DudeYarvie/JARViE_Home_Automation_Modem/Firmware/src/Shahara/Programming the PLM Shahara CCA using Atmel Studio.pdf

# Programming the PLM Shahara

Author: Jarvis Hill
Date: 26-MAR-2023
Purpose: Use this document to perform ISP programming on the PLM Shahara
1. Navigate to the following website, https://www.microchip.com/en-us/development-tools-tools-and-software/avr-and-samdownloads-archive (https://www.microchip.com/en-us/development-tools-tools-and-software/avr-and-sam-downloads-archive)
2. Download and install Atmel Studio 7 on your PC by clicking the link circled below,

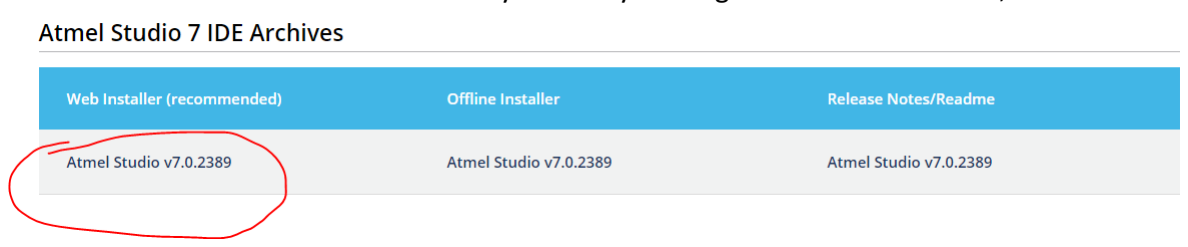
[picture p15: figure]

3. Connect the programmer to the PC using the appropriate USB cable.
4. Open/launch the Atmel Studio software on the PC,
5. Once the application opens, navigate to Tools -> Device Programming

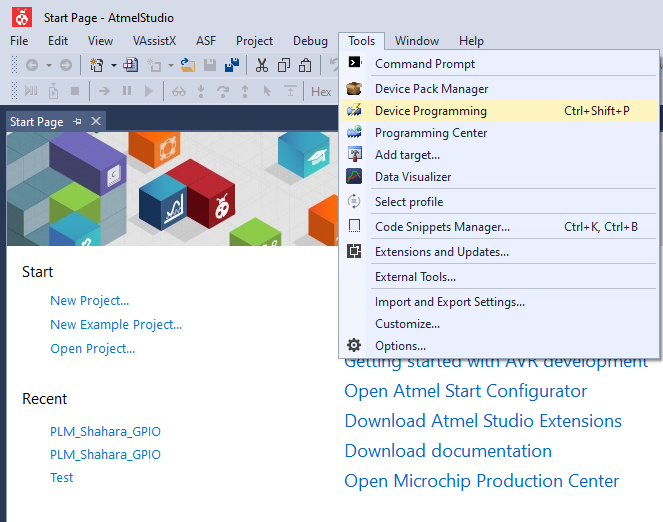
[picture p16: figure]
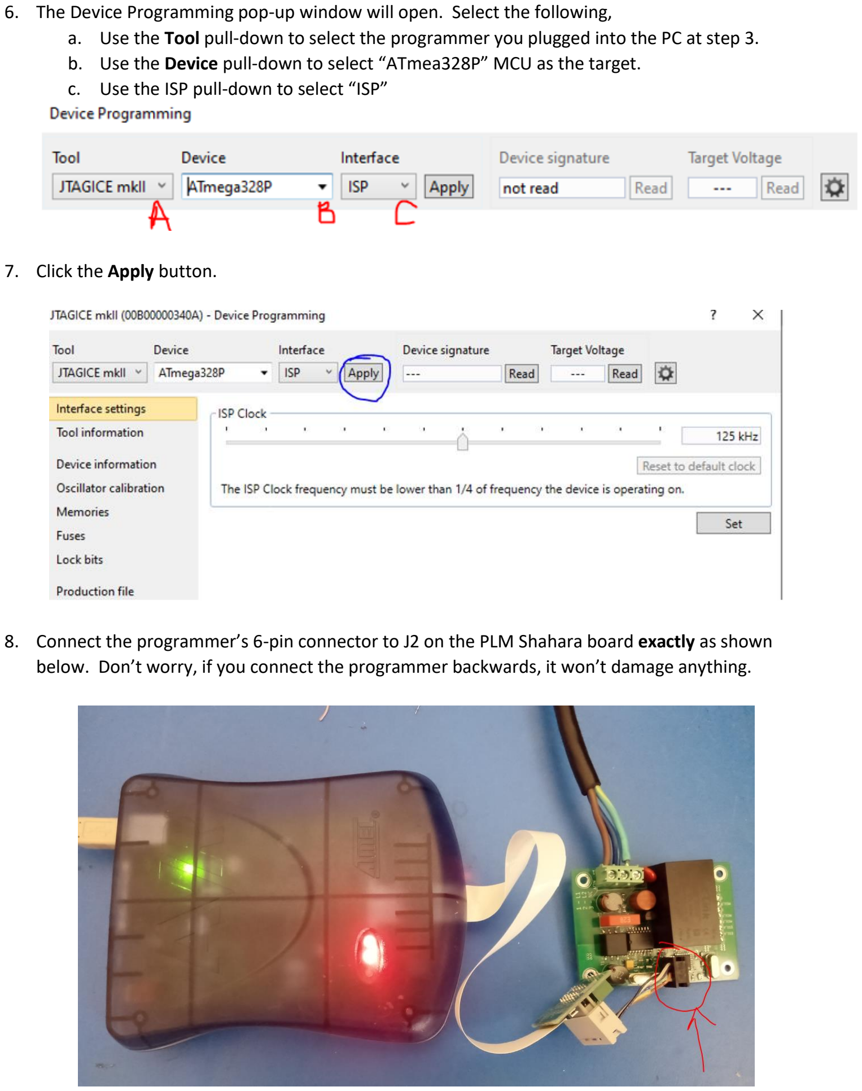
[picture p17: page 2]

6. The Device Programming pop-up window will open. Select the following,
a. Use the Tool pull-down to select the programmer you plugged into the PC at step 3.
b. Use the Device pull-down to select “ATmea328P” MCU as the target.
c. Use the ISP pull-down to select “ISP”
7. Click the Apply button.
8. Connect the programmer’s 6-pin connector to J2 on the PLM Shahara board exactly as shown below. Don’t worry, if you connect the programmer backwards, it won’t damage anything.

9. Power the PLM Shahara board by supplying 120 or 240VAC to the ACIN L1 and L2 screw terminals. The green light on the programmer should turn-on. If the LED does not come on, remove, rotate the programmer’s header by 180 degrees and plug it back into the 6-pin header on the Shahara board.

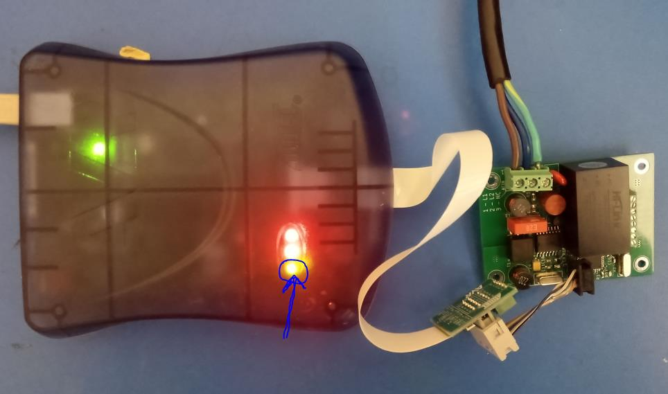
[picture p18: figure]

10. Click the Read button in the Device Signature Field. Verify the following,
a. A 4-digit HEX number populates in the Device Signature field
b. The Target Voltage is between 4.5V to 5V.
c. Device ID is read OK.

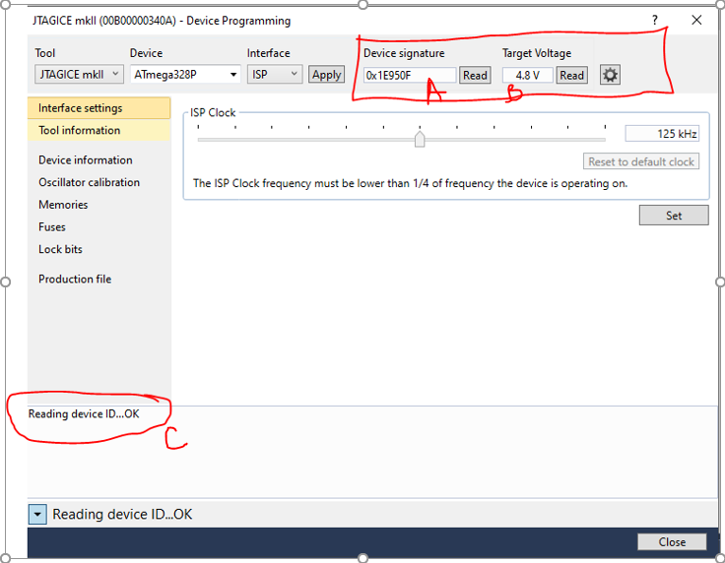
[picture p19: figure]

11. Navigate to the Fuses page. Ensure the CCA fuses are set correctly,
a. Click the Read button.
b. Verify that the EXTENDED, HIGH and LOW fuse registers read as shown. If not, update the registers with the values below.
c. Ensure the boxes are checked as shown.
d. IF the fuses registers were update, click the Program button

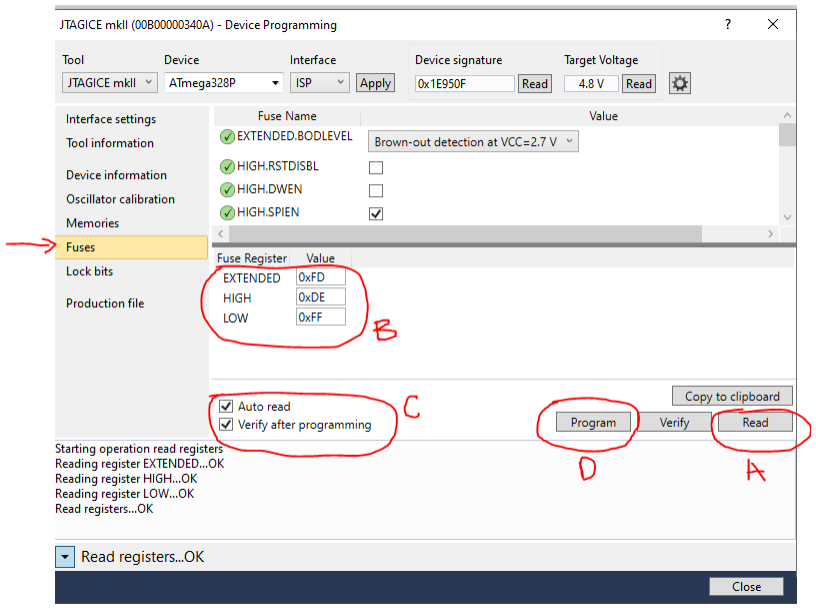
[picture p20: figure]

12. Navigate to the Memories page. Verify that the following boxes are checked.

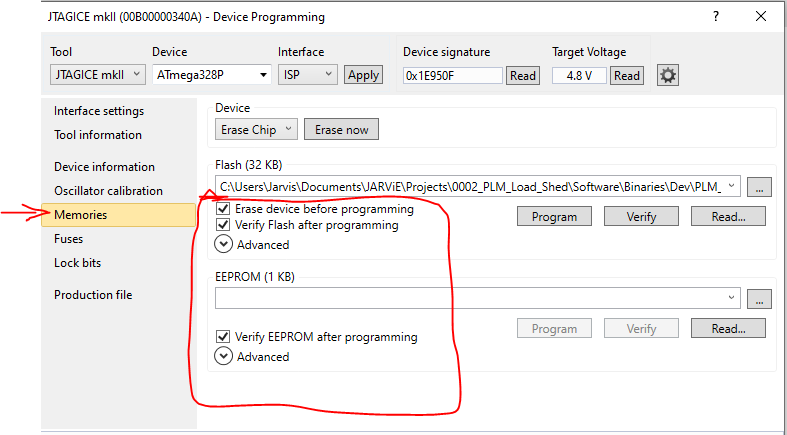
[picture p21: figure]

13. Load the program to be placed on the PLM Shahara CCA,
a. Click the button with the “…” in the Flash (32 kB) section
b. Select the .hex file to program onto the CCA
c. Double click the file to select it or click the file once to highlight it and then click the Open button in the file explorer window.

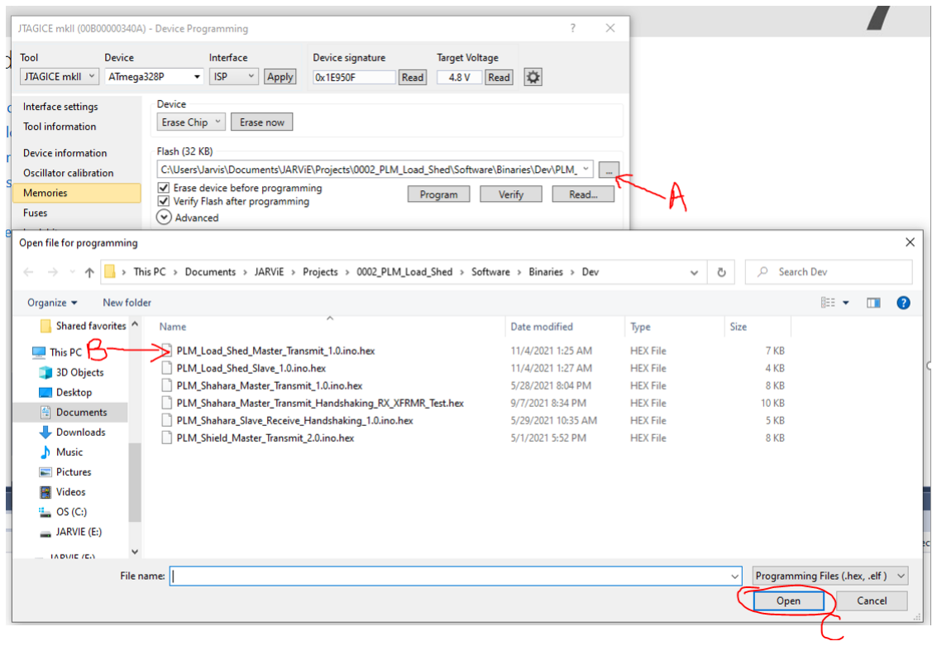
[picture p22: figure]

14. Upload the program to the PLM Shahara,
a. Click the Program button to load the CCA with the selected firmware (.hex file)
b. Verify that the programming went OK.

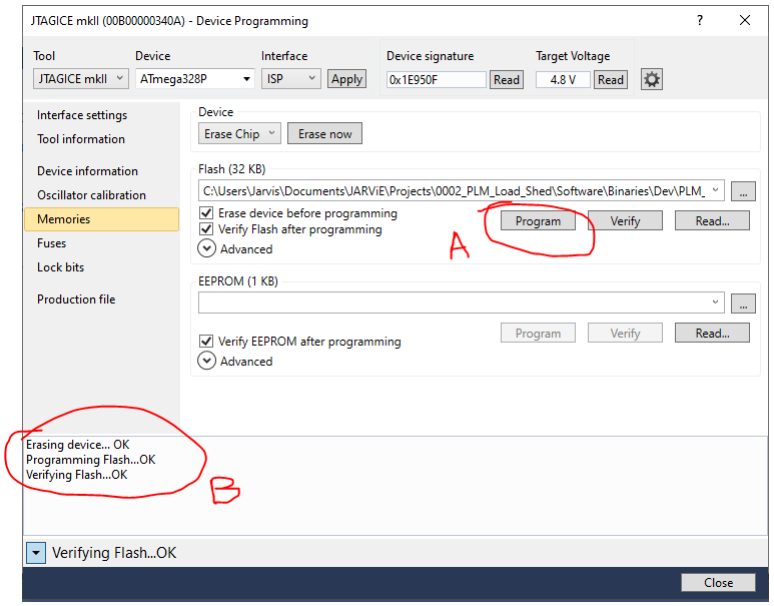
[picture p23: figure]
