DudeYarvie/JARViE_Home_Automation_Modem/Reference Docs/Pics/Demo_Kit.jpg

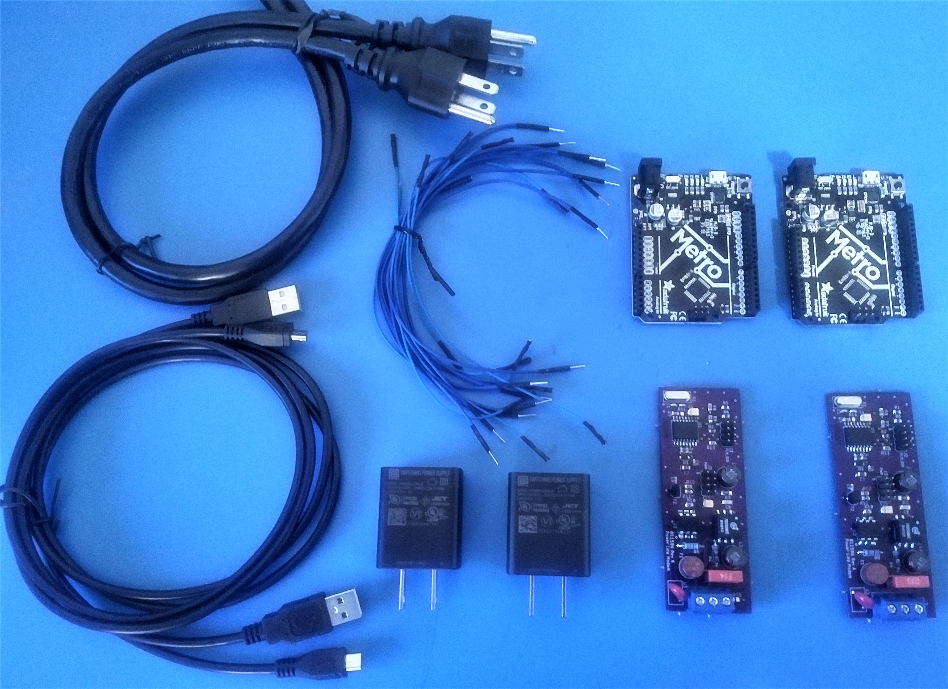
Reference Docs/Pics/Demo_Kit.jpg
