DudeYarvie/JARViE_Home_Automation_Modem/Reference Docs/Pics/JARVIE_PLM_Annotated.png

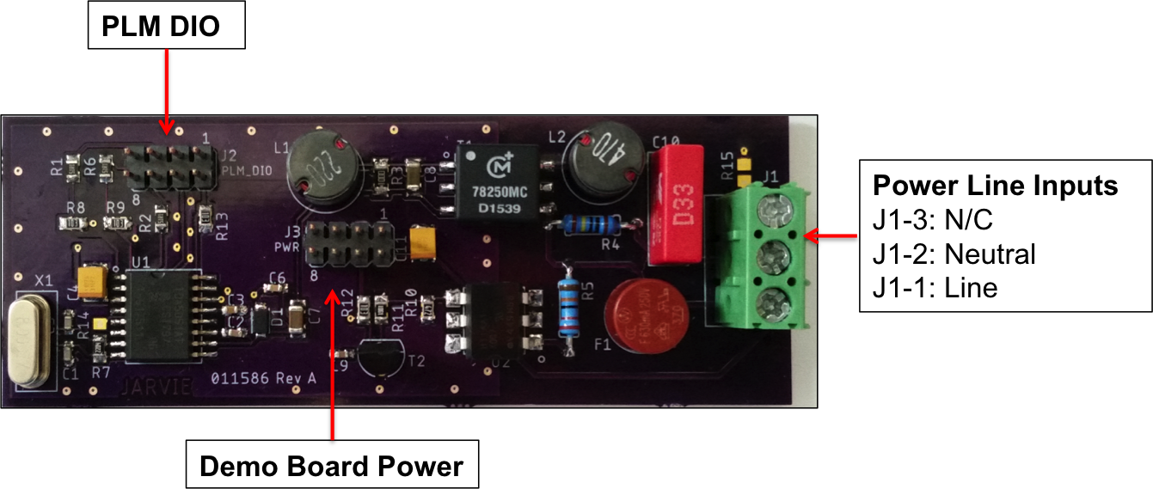
Reference Docs/Pics/JARVIE_PLM_Annotated.png
