DudeYarvie/JARViE_Home_Automation_Modem/Reference Docs/Pics/JARViE_PLM_HAT_AC_Application.png

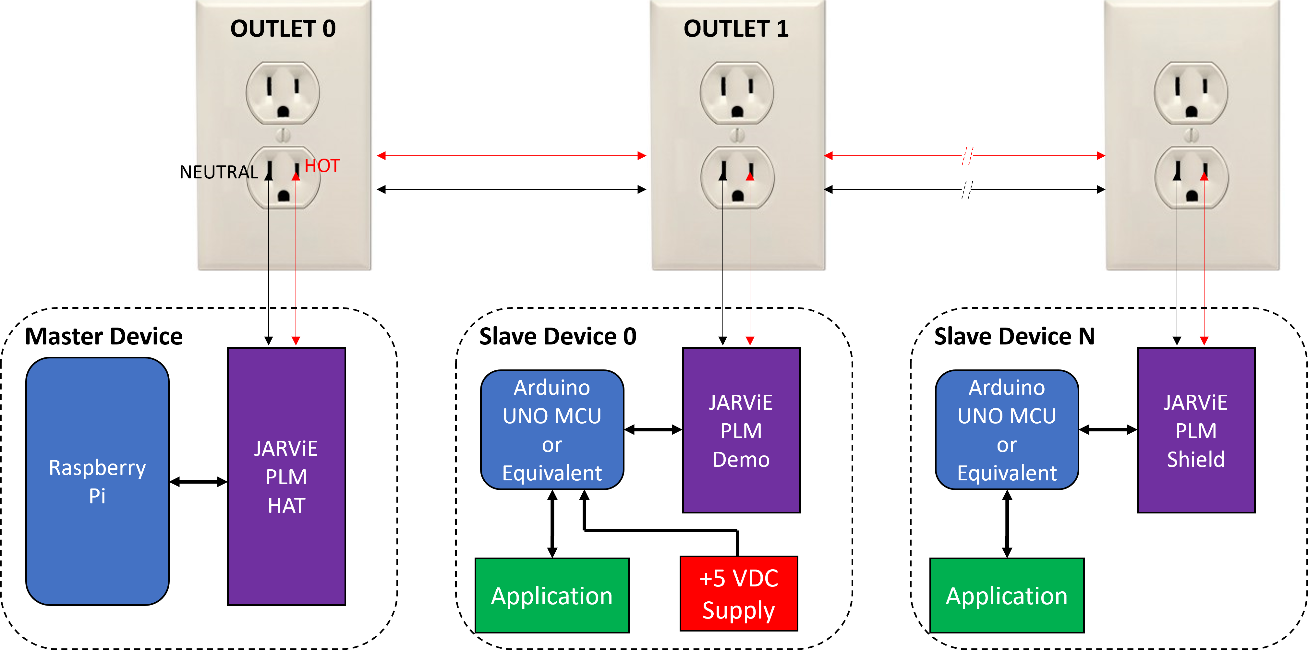
Reference Docs/Pics/JARViE_PLM_HAT_AC_Application.png
