DudeYarvie/JARViE_Home_Automation_Modem/Reference Docs/Pics/PLC_Coupling_Circuit_from_ACIN_to_PLC_Modem_Voltage_Magnitude_vs_Frequency.png

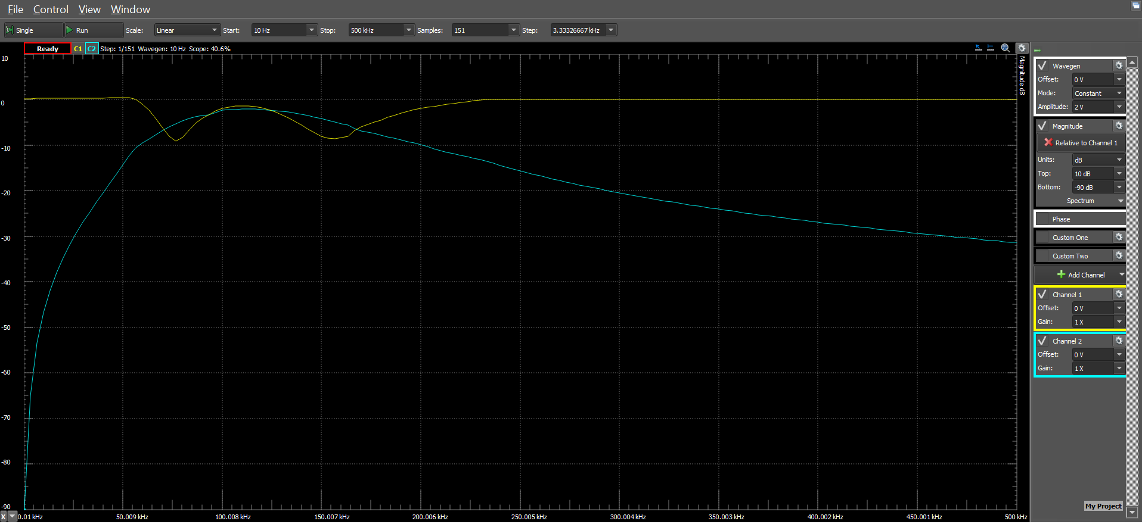
Reference Docs/Pics/PLC_Coupling_Circuit_from_ACIN_to_PLC_Modem_Voltage_Magnitude_vs_Frequency.png
