DudeYarvie/JARViE_Home_Automation_Modem/Reference Docs/Pics/PLC_Coupling_Circuit_from_PLC_Modem_to_ACIN_Voltage_Response_vs_Frequency.png

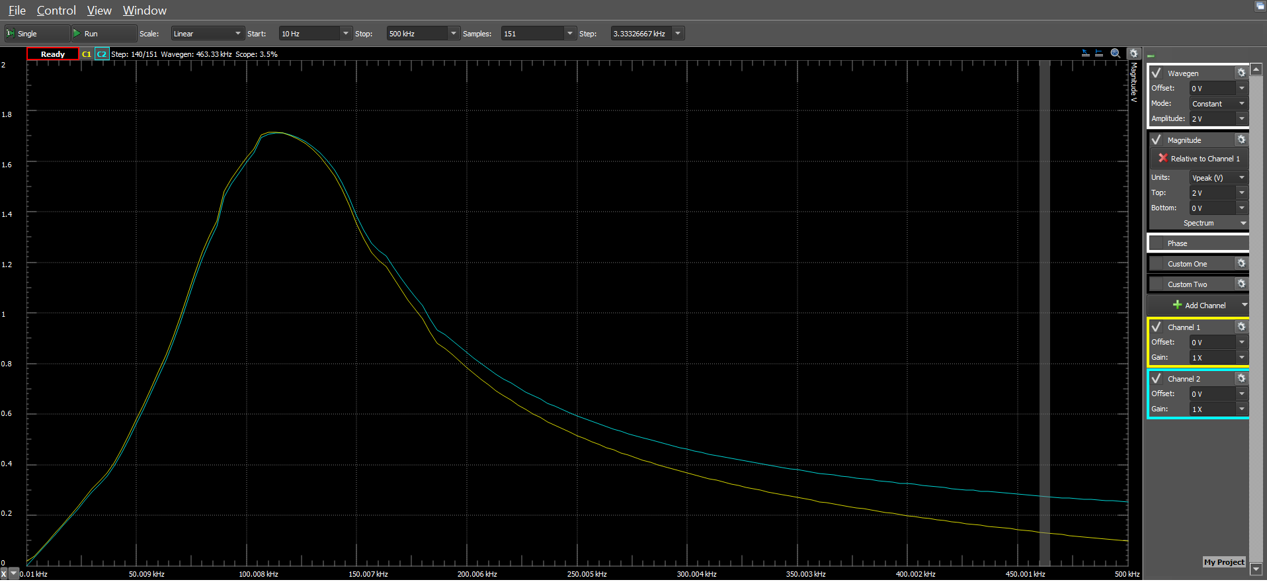
Reference Docs/Pics/PLC_Coupling_Circuit_from_PLC_Modem_to_ACIN_Voltage_Response_vs_Frequency.png
