DudeYarvie/JARViE_Home_Automation_Modem/Reference Docs/Pics/PLM_Shahara_Board_Rendering.PNG

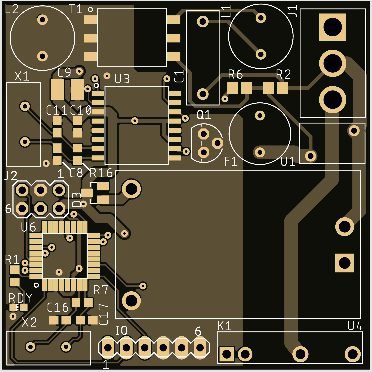
Reference Docs/Pics/PLM_Shahara_Board_Rendering.PNG
