DudeYarvie/JARViE_Home_Automation_Modem/Reference Docs/Pics/Shield_Demo_Kit.jpg

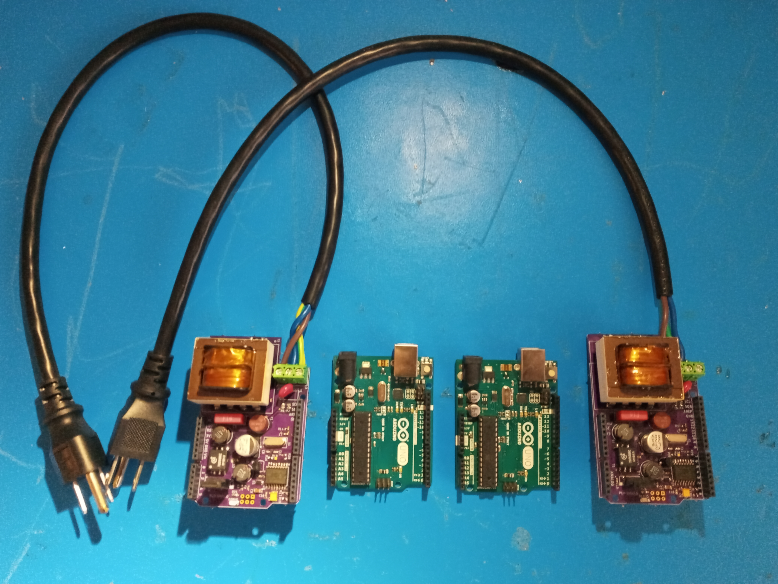
Reference Docs/Pics/Shield_Demo_Kit.jpg
