DudeYarvie/JARViE_Home_Automation_Modem/Reference Docs/RPI_HAT_Bringup.docx

+5V Raw Back Powering

1. Supply external +5V @ 30mA min current limited supply to +5V and GND inputs on RPI header
2. Measure voltage across C6, C12 or C13 and ensure voltage measurement is less than 0.5V

Results: Voltage read 0V across C13 when a +5V supply was connected to RPI header. Body diode of Q1 is correctly preventing a back-powering event

PLM EXT CLK INPUT

1. Measure CLK signal supplied at CLK_OUT pin of PLM IC using an oscilloscope.
2. Verify measured CLK_OUT frequency equals fosc/2 = 4MHz.

Results:

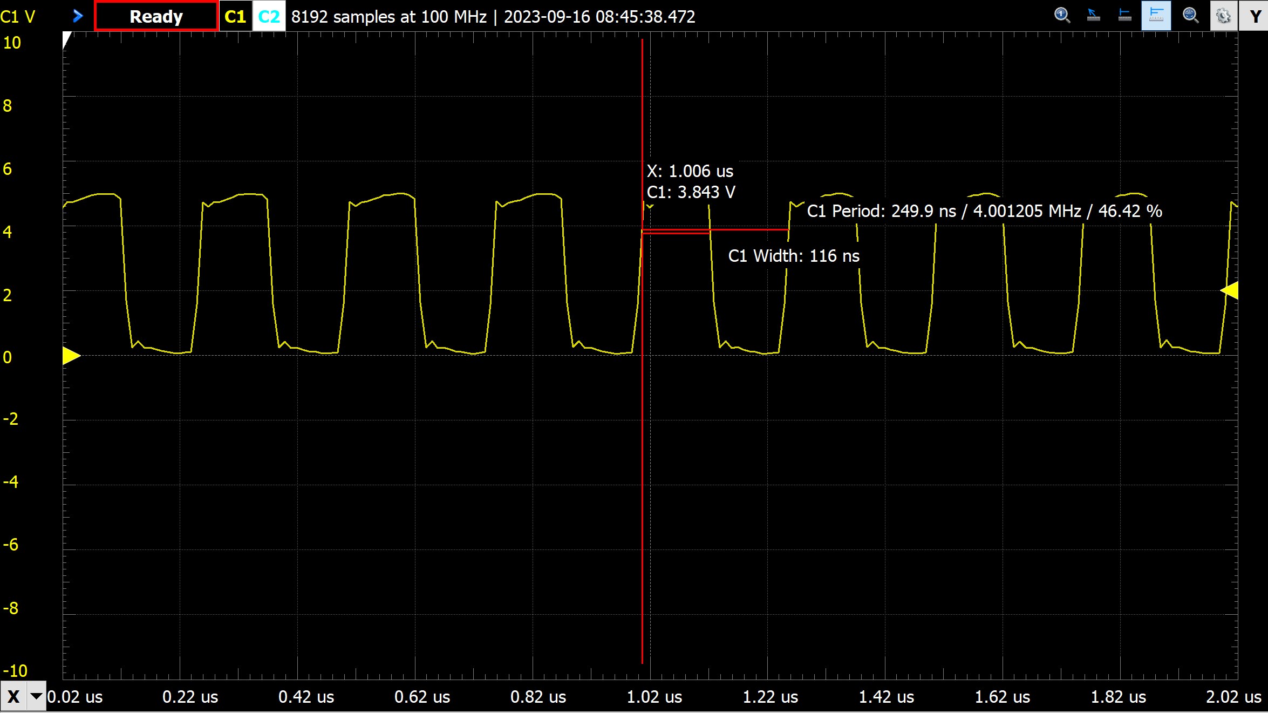
[picture p37: figure]

PLM TX OUTPUT

1. Supply a square waveform generator to PLM TX pin
2. Measure signal at ACIN output

Results

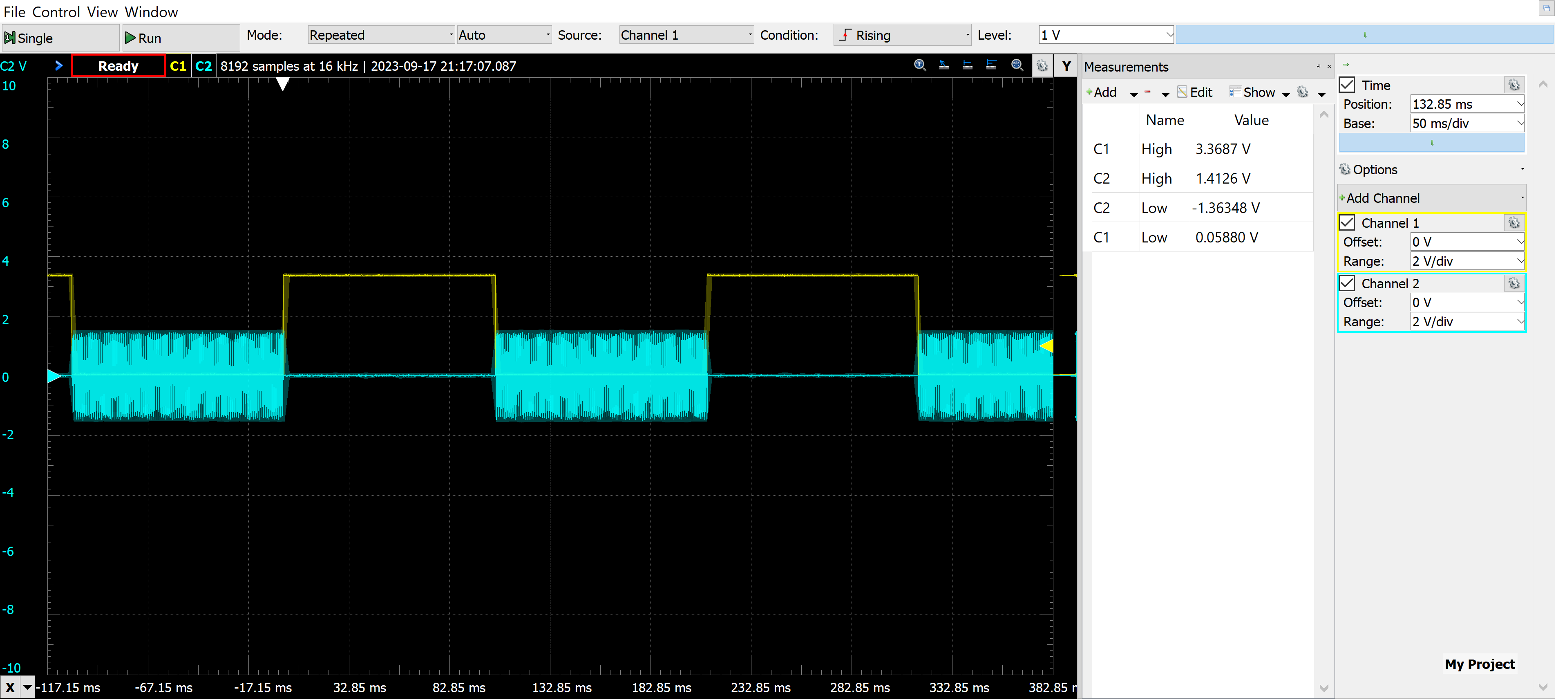
[picture p38: figure]

JARViE was sent on RPI ttyS0 serial bus:

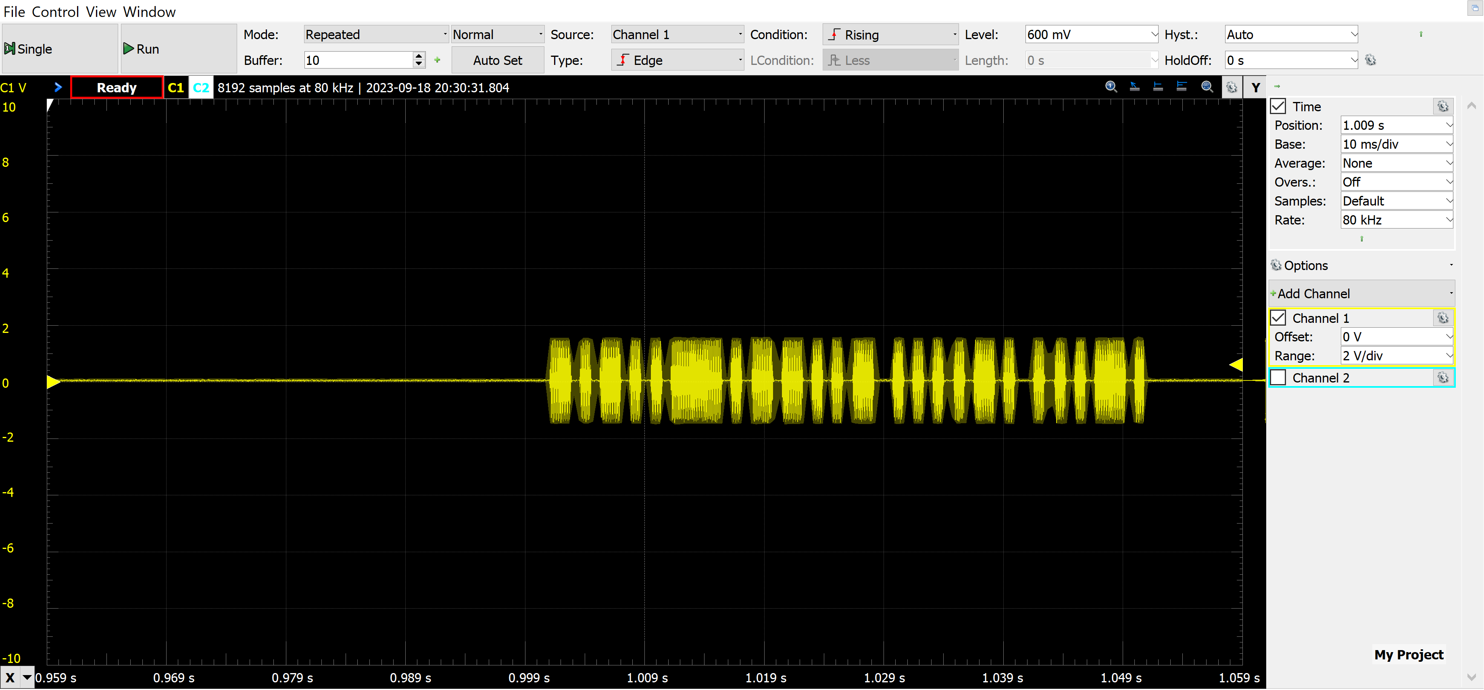
[picture p39: figure]

Communications Carrier frequency:

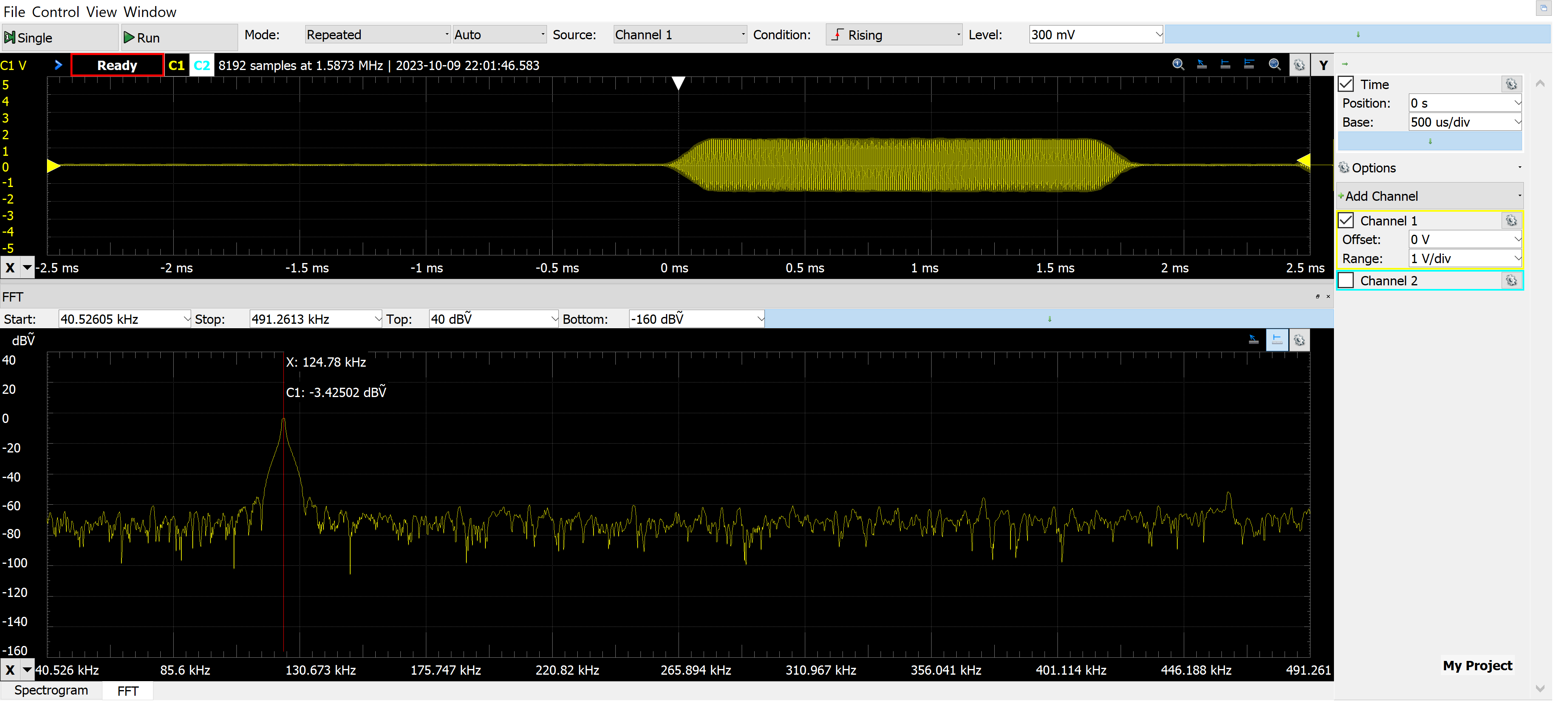
[picture p40: figure]

RPI BOOT w/ AC power adapter

1. Power down raspberry PI
2. Plug RPI Shield into raspberry PI
3. Power on raspberry PI using a USB-C power adapter (5V @ ?A)
4. Verify PI boots normally
5. Measure +3V and +5V power rails on the shield

Results

PI boots up properly

+3V and +5V power rails look good

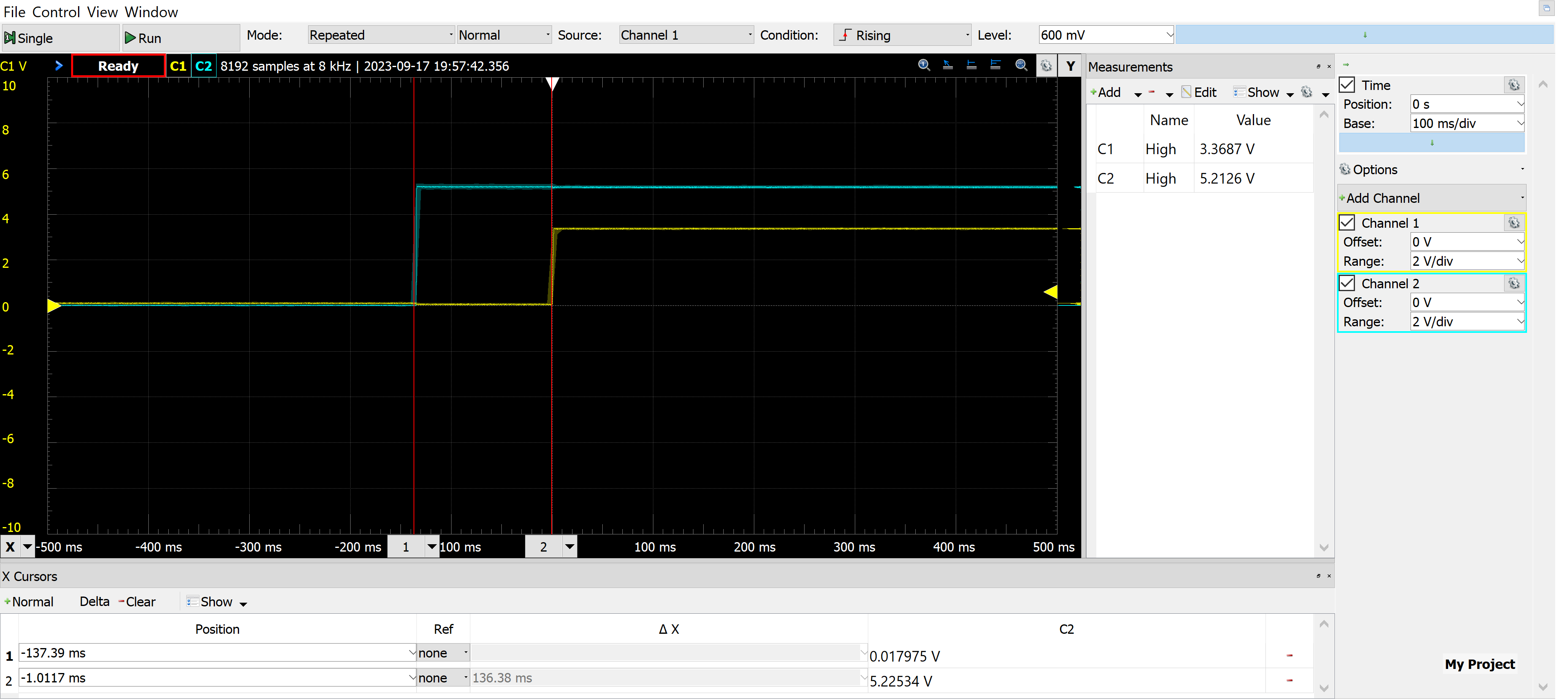
[picture p41: figure]

RPI BOOT w/ Shield 115VAC power

1. Power down raspberry PI
2. Plug RPI Shield into raspberry PI
3. Connect AC power to RPI Shield via ACIN connector
4. Plug AC power plug into 115VAC wall outlet
5. Verify PI boots normally
6. Measure ACIN, +3V and +5V power rails on the shield w/ DMM

Results

RPI booted up properly

ACIN = 124.0 VAC

+5V = 4.94 VDC

+3V = 3.29 VDC

3V to 5V Level Translation

1. Generate square wave on PLM DIN RPI TX pin
2. Connect scope to PLM DIN RPI TX pin and set scope to trigger on rising edge of this signal
3. Connect scope to PLM DIN pin

Results

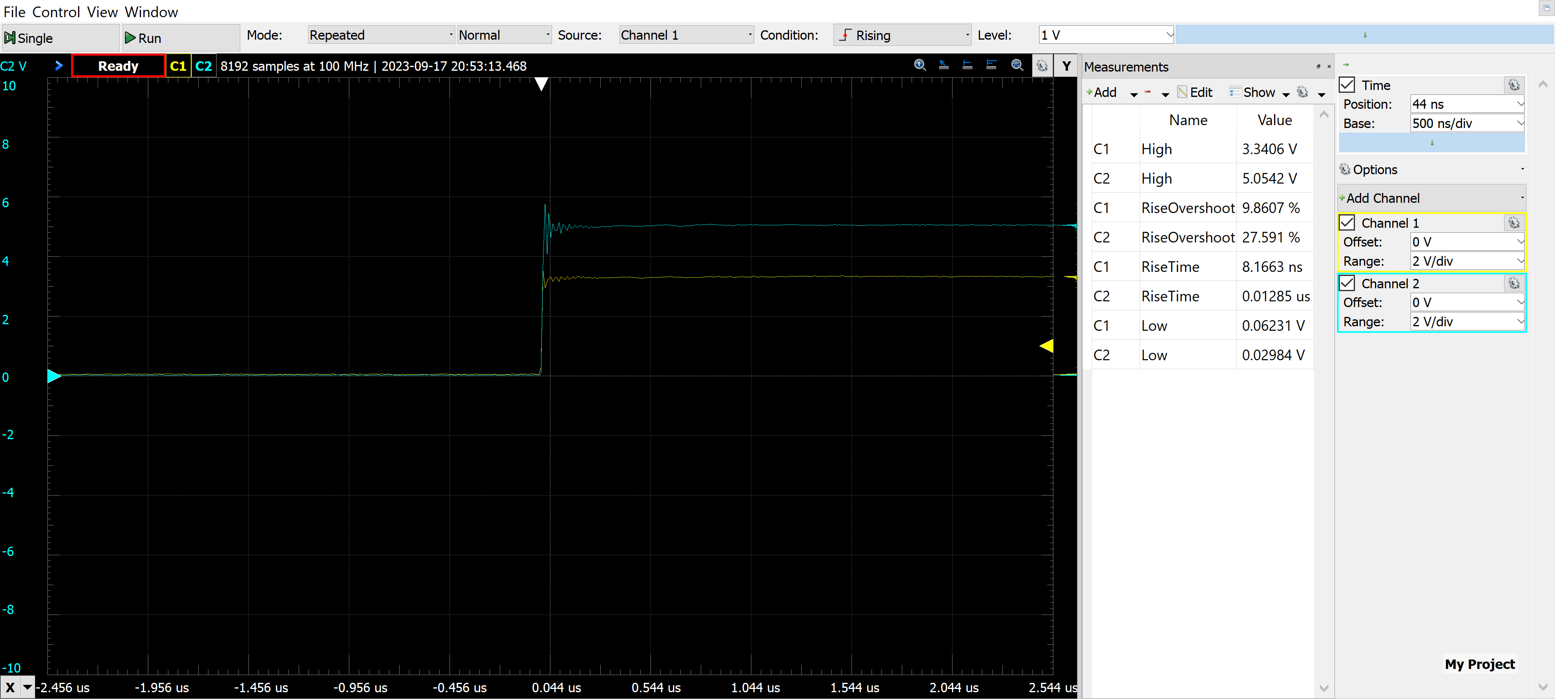
[picture p42: figure]
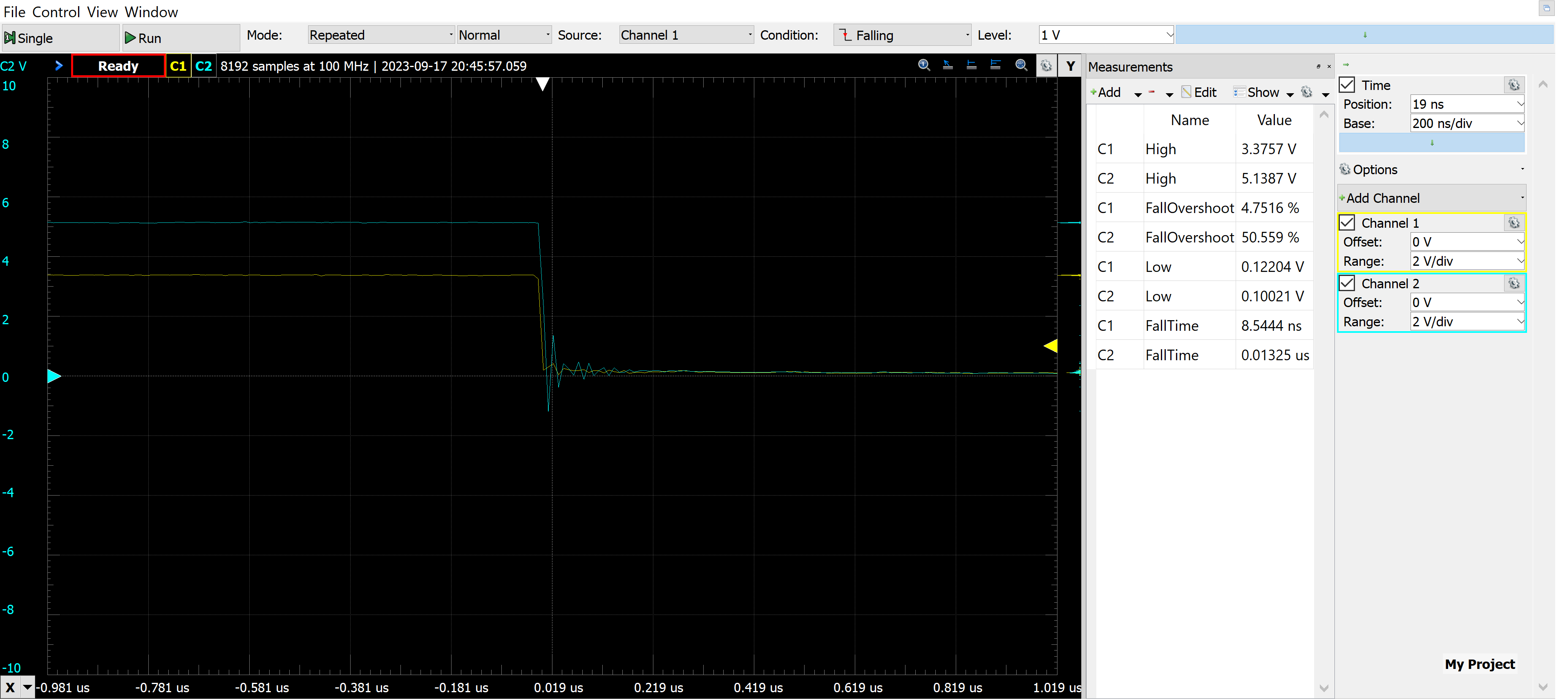
[picture p43: figure]

RPI HAT Powerline Communications

1. Enable RPI to run powerline comm script at boot.
2. Plug RPI HAT into raspberry PI
3. Plug RPI HAT in AC home outlet
4. Plug JARViE powerline demo board into a home outlet
5. …..add more steps

Results

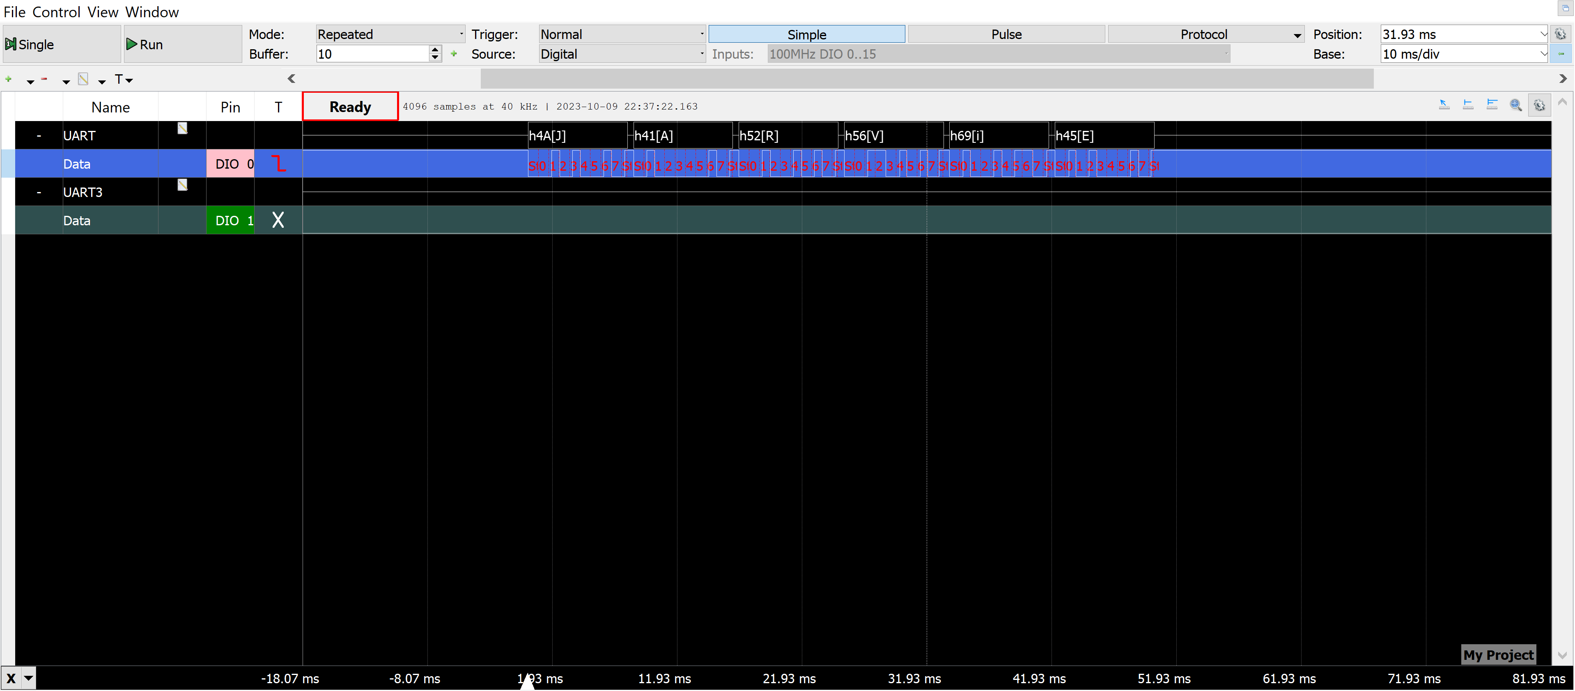
[picture p44: figure]

Setup the WLAN

1. Connect keyboard and mouse to RPI USB A ports.
2. Connect RPI to a display via micro HDMI port.
3. Follow instructions here to setup WLAN: https://raspberrytips.com/raspberry-pi-wifi-setup/
4. Once the WLAN is setup, connect to a network.
5. Verify that the RPI does not lose power or reboot.
6. Unpower RPI and apply power via RPI HAT, ensure RPI successfully boots and don’t not get stuck in a boot loop.

Setup Remote Desktop Access (RDP) on RPI

1. Open terminal on RPI and type sudo apt-get update to ensure you have the latest apt-get packages. If error is report stating an error or packages were ignored, re-run cmd until all packages install.
2. Follow instructions here to setup RDP on the RPI: https://elluminetpress.com/2020/03/connect-to-your-raspberry-pi-remotely/

SSH into RPI

1. Enable and login via SSH by following these instructions: https://phoenixnap.com/kb/enable-ssh-raspberry-pi
2. Type hostname -I into terminal on RPI, it will print the IP address, this is the IP address to use for the SSH connection in order to SSH into the RPI.

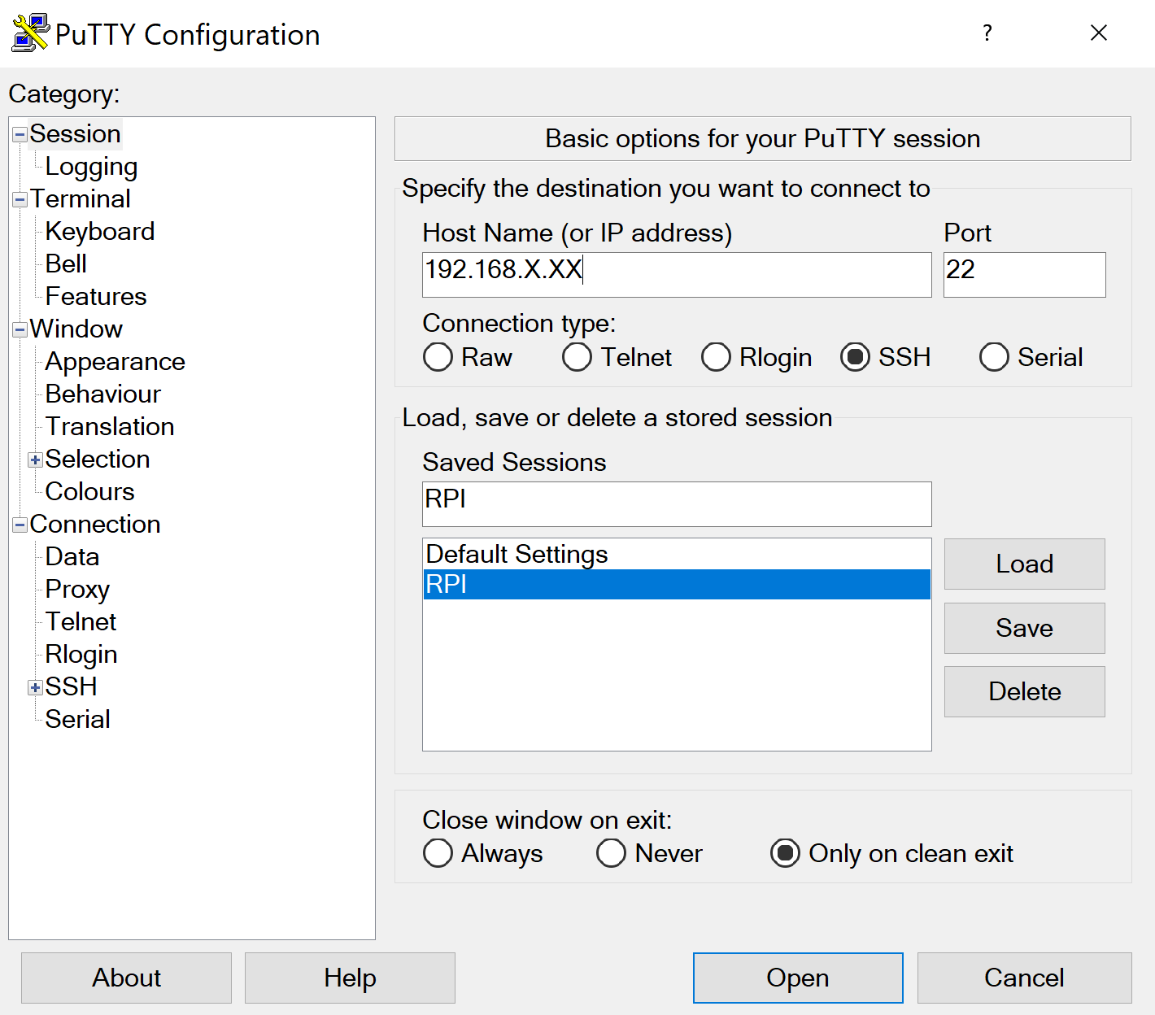
[picture p45: figure]
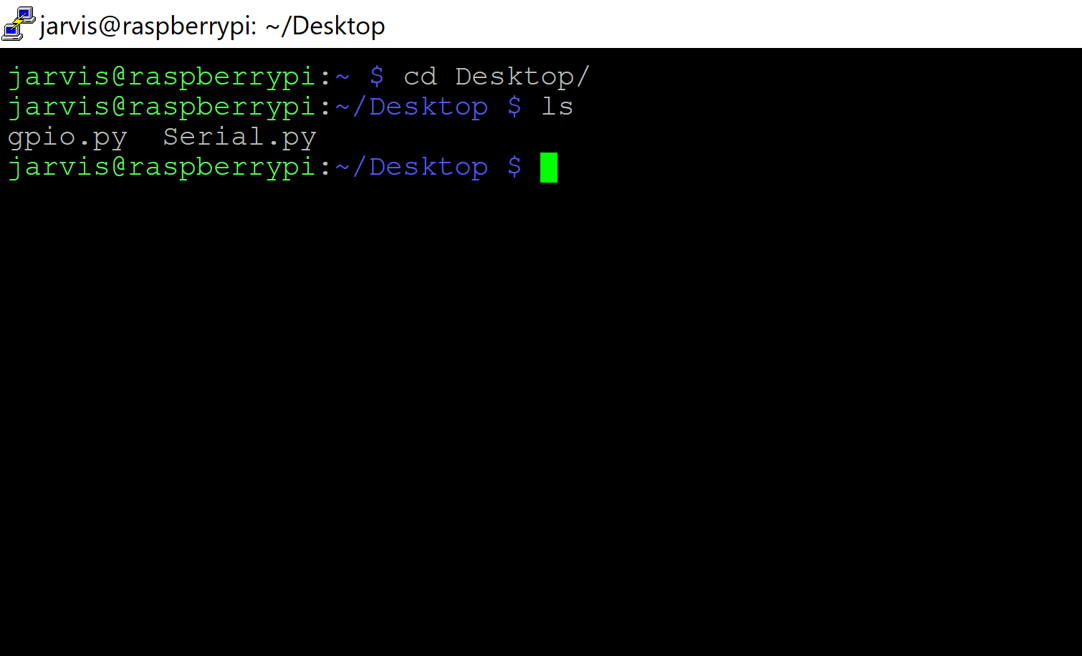
[picture p46: figure]

Run Python script at boot (init.d approach is what I used)

1. https://www.dexterindustries.com/howto/run-a-program-on-your-raspberry-pi-at-startup/
