DudeYarvie/JARViE_Home_Automation_Modem/(threads)

Thread 1 (2020-10-13):

plc dont work for more then 2 meters, and without AC volt

shalom198, 2020-10-13:
hi,
I built your electrical circuit, and it only works if I connect the zero of the 5V between the two circuits ?!
Why ?

DudeYarvie, 2020-10-19:
After reviewing your schematic for the PLM design, we found that the GND connection on the RLC filter was missing.  See blue annotation.  After you made this correction, you're able to get consistent but incorrect messages over the AC power lines.  We're in the process of looking for other issues and solutions.
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

shalom198, 2021-05-28:
the problem was the 220V
the gnd i fixed allredy

Thread 2 (2021-05-18):

the filter of 220V dont works

shalom198, 2021-05-18:
Hello
I bought the PLC modules from you about a year ago
And I could not turn them on the electricity, we were in touch and could not solve the problem and then the corona disrupted my life, now I went back to activity again,
I reassembled the system, and returned to the same condition, I have good communication when there is no electricity on the line, but when the electricity is turned on the communication falls
somthing with the AC filter is not works well
What to do ??

Closed 2021-05-28.

Thread 3 (2021-05-27):

220V dont works

shalom198, 2021-05-27:
the module works fine with 110V but dosnt works with 220V
what wrong ??

DudeYarvie, 2021-05-28:
Shalom198 and I are discussing this via e-mail.  We'll update the thread in a clean way that shows issue + solution once complete.  Now I'm trying to understand his setup since I can't physically see it.  I'm also working setting up a 220VAC PLM master and slave to verify that communications are still successful at 220VAC.

DudeYarvie, 2021-05-30:
Shalom,

I understand you're using 220VAC @ 50 Hz source.  Please provide pictures or diagrams to describe the setup to me in **detail**.  I need know all the components involved and how they are interconnected.  I have no idea what your setup looks like, I need this info in order to troubleshoot it and provide a solution.

-Jarvis

xfbs, 2021-07-19:
If you need someone else to test it out on a 230V power line, I am hereby volunteering.

shalom198, 2021-07-20:
Hi
Thank you very much for the desire I very much appreciate it
My situation today is that on the power line of the 220V there is no
communication
I got a scoop device, and found that there is noise in the line (I measured
at the point of the TX) even when the TDA does not transmit, the noise is
about KHZ 70-90, 200-300MV
There seems to be some resonance
I do not know how to use the scoop device professionally, I thought to
measure the power line itself to see if the noise is in the power line
regardless of the PLC or the PLC creates it
But I do not know how to measure the power line using the scoop device, I
am afraid to burn it

‫בתאריך יום ג׳, 20 ביולי 2021 ב-1:57 מאת ‪Patrick Elsen‬‏ <‪
***@***.***‬‏>:‬

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

shalom198, 2021-07-21:
Hello again
I discovered something interesting, I replaced the serial capacitor at the
entrance (C10)
Instead of 47NF I put 470NF (I saw that this is the value in the APLICATION
NOTE)
I replaced only one module, and then an interesting thing happened, the
second module read the communication correctly, however when I also
replaced the capacitor in the second module, again there was a complete
lack of communication

‫בתאריך יום ג׳, 20 ביולי 2021 ב-23:00 מאת ‪SH JO‬‏ ***@***.***
‬‏>:‬

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

DudeYarvie, 2022-01-13:
Shalom,

Restore the demo/breakout boards with the original 47nF CAP and swap out XTAL, X1, with a 7.3728 MHz 18pF standard crystal like [MPN: ABL-7.3728MHZ-B2](https://www.mouser.com/ProductDetail/ABRACON/ABL-73728MHZ-B2?qs=H8AWquzS%2FlMl5W3SEVtd2Q%3D%3D).  This adjusts the PLM carrier frequency to 115kHz which matched the resonant frequency of the tuning circuitry.   I strongly believe the boards I sent to you have a 8MHz crystal which sets the PLM carrier frequency to 125kHz which does not match the resonance of the tuning circuit.

shalom198, 2022-01-16:
, I switched to 7.3728 MHz, but it did not work , the same problem.
Currently the system only works if I put an autotransformer (220V > 110V )
between the  mains  of electricity
and the line on which I put the POWERLINE

Thank you very much for everything, hoping we can find a solution

‫בתאריך יום ו׳, 14 בינו׳ 2022 ב-9:28 מאת ‪SH JO‬‏ ***@***.***‬‏>:‬

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

DudeYarvie, 2022-01-17:
Ok well thanks for trying it.

shalom198, 2022-01-17:
Attached are my attempts

‫בתאריך יום ב׳, 17 בינו׳ 2022 ב-22:48 מאת ‪Jarvis Hill‬‏ <‪
***@***.***‬‏>:‬

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

Closed 2024-08-04.

Thread 4 (2021-07-19):

Kits sold out, ideas

xfbs, 2021-07-19:
Hey Yarvie,

this is some really awesome stuff. I've always thought it would be a cool idea to have a DIY powerline home automation setup, it just makes sense. Got some questions for ya:

* The kits are currently sold out, are you planning to make some more?
* Would it be possible to monitor the amps going out of the kit? I think that would be cool, imagine being able to monitor your house's power consumption in real time.
* Wouldn't it be cool if the handshake between master and slave units used some kind of cryptographic pairing (I'm thinking elliptic curve based), so that you can avoid 'attacks' or the neighbors snooping traffic/controlling devices?

So many cool possibilities here.

DudeYarvie, 2021-07-20:
Tindie has just been updated with two more boards in stock.  Two boards are required for one kit.

You're exactly right, there are some many ideas!  The development boards/kit enable the possibility to explore all those ideas.  Boards will ship 1 to 2 days after order.

DudeYarvie, 2021-07-26:
I found this cool IC for power monitoring, MPN: ACS37800KMACTR-090B3-I2C

Closed 2021-08-04.

Thread 5 (2023-03-26):

Arduino IDE Compile Error: "invalid conversion from 'char*' to 'uint8_t*"

Intechgreater, 2023-03-26:
As shown in the attached screenshot, getting the compile error "invalid conversion from 'char*' to 'uint8_t*" on line 49 in PLM_Shahara_Master_Transmit_1.0.ino:
checksum = fletch_check(msg, strlen(msg));

Please advise

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

DudeYarvie, 2023-03-26:
Did you copy the following files from the Library directory to your Arduino sketch folder?

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

Intechgreater, 2023-03-26:
Appreciate the rapid response! Yes, the entire firmware directory was copied to the Arduino sketch folder. Got it to work by typecasting the msg variable:
 `checksum = fletch_check((uint8_t*)msg, strlen(msg)); `

DudeYarvie, 2023-03-26:
FYI, when I compile the code with Arduino 1.8.13, it compiles successfully.
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

I believe you could also update fletch_check to pass in  a _char *data_ instead of _unint8_t *data_ by updating the function to,
uint16_t fletch_check( char *data, int count );
This change would need to be done in the .ino, PLM.cpp and PLM.h.

Intechgreater, 2023-03-26:
Replacing `uint8_t *data` with `char *data` in the .ino, PLM.cpp and PLM.h did compile and run. Thanks!
Another hurdle was finding the correct [board core & fuse settings](https://github.com/MCUdude/MiniCore.git) for the actual chip model on my demo boards - a regular ATmega328 as opposed to the ATmega328**P** in the docs. Exciting to at least get the boards modified for the application and onboard blue LED blinking so far!

DudeYarvie, 2023-03-26:
I think you're bringing up some good questions/topics.  For the record,  I believe the only difference between the ATmega328 and ATmega328p is the "p" denotes the lower power option.  I would think the fuse settings for both silicon are the same.  I used the fuse settings in the repo to program both the regular and p versions and seen no issues.
If you have seen issues or seen that different fuse settings are required, please share your findings.(https://github.com/DudeYarvie/JARViE_Home_Automation_Modem/tree/master/Firmware/src/Shahara)/Shahara_ATmega328p_MCU_FUSE_Settings.txt

Closed 2023-03-26.

Thread 6 (2023-03-26):

Arduino IDE Issues Related to ATmega Core, Bootloader, & Fuse Settings

Intechgreater, 2023-03-26:
In the process of loading a first example sketch I discovered my demo boards have a slightly different MCU model (ATmega328 instead of ATmega328**P** in the docs). I understand they're essentially the same with the P version being a lower power option and should be programmable with the same settings. However, their device signatures being different prevented sketch upload. Since I'm not well versed in this aspect of Arduino and didn't realized at the time I could have just overridden the signature check I ended up just overwriting the preprogrammed bootloader and fuse settings with [MCUdude's MiniCore](https://github.com/MCUdude/MiniCore).
Here are my Arduino IDE menu fuse settings, with an UNO configured to be an ISP:
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
So this setup works but only for the first sketch upload. For each new upload I have to reburn the bootloader to get it to upload, otherwise I get these errors:
[Upload Errors.txt](https://github.com/DudeYarvie/JARViE_Home_Automation_Modem/files/11072228/Upload.Errors.txt)
I see the fuse settings provided here [Firmware/src/Shahara/Shahara_ATmega328p_MCU_FUSE_Settings.txt](Firmware/src/Shahara/Shahara_ATmega328p_MCU_FUSE_Settings.txt) but not sure how to program them yet. One thing I question though is `EXTXOSC_8MHZ` in `SUT_CKSEL = EXTXOSC_8MHZ_XX_16KCK_14CK_65MS`. I would it expect to be `EXTXOSC_16MHZ` to match the external 16MHZ crystal.
Thoughts?

DudeYarvie, 2023-03-26:
OK so you’re developing code or at least trying to update code on the Shahara using the Arduino IDE, correct? What programmer are you using?

Intechgreater, 2023-03-26:
Yes, currently in Arduino IDE 1.8.16
Using an UNO R3 running ArduinoISP as the programmer, connected via the ICSP header to Shahara, but with the Reset signal coming from UNO pin 10. And a 10uF cap between GND and RESET.

Intechgreater, 2023-03-27:
I now see thorough instructions on how to program via Atmel Studio were uploaded. Thanks!
In the meantime I installed the current version now called Microchip Studio 7.0.2594 (twice) but it gives me an exception error when trying to open Tools -> Device Programming, and when trying to create a new project!
Will try your approach next...
Also noticed the new Arduino IDE version 2.0.4 and installed it. The errors with subsequent sketch uploads went away. BUT there's another issue in this and previous version: in PLM_Shahara_Master_Transmit_Handshaking_1.0 (and slave version) the line `msgBuffer[MAX_BUF_SIZE]="";` produces the error `invalid conversion from 'const char*' to 'char' [-fpermissive]`
If I replace `""` with `'\0'` it will compile but does that still accomplish the same thing, or what do you suggest?

Intechgreater, 2023-03-27:
Dang, still getting the same errors in Atmel Studio as I did in Microchip Studio. From the research I've done so far it may have something to do with Microsoft Visual Studio?

1. Tools -> Device Programming:

> Provide value on 'System.Windows.Baml2006.TypeConverterMakupExtension' threw an exception.

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

2. File -> New -> File or Project:

> Failed to create a 'ImageSource' from text'..\Images\Medium.png'.

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

Intechgreater, 2023-03-27:
Was able to get Atmel Studio installed on a different PC and Device Programming to come up. Will take it further next chance I get...

Intechgreater, 2023-03-28:
The High Fuse value in the programming instructions corresponds to EESAVE and BOOTSZ parameters different than those in Shahara_ATmega328p_MCU_FUSE_Settings.txt
What should it be?
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

DudeYarvie, 2023-03-29:
I see the following settings in the Shahara_ATmega328p_MCU_FUSE_Settings.txt.
_FUSE Registers,
-> EXTENDED = 0xFD (valid)
-> HIGH = 0xDE (valid)
-> LOW = 0xFF (valid)_

 Are you saying there's a difference between settings provided in the fuse setting and programming documents?

Intechgreater, 2023-03-29:
It's the settings below those 3 lines in the txt doc:

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

Intechgreater, 2023-03-29:
While waiting for a real programmer compatible with Atmel Studio to arrive, I was able to learn how to read/set the fuse registers and upload the binaries you provided via command line using avrdude. Intimidating at first knowing about the risks but relatively easy once acquainted, and satisfying!
Per your suggestion for testing, the master and slave handshake examples each on a Shahara connected together via J1 (no AC power yet), and getting 5V from an UNO, works!
5 fast LED blinks on master -> slave LED on -> 8 slow LED blinks on master -> 5 fast blinks on master -> slave LED off -> 8 slow LED blinks on master, repeat...
However, when the system is connected to 12VAC (converted to 5VDC for circuit power on each Shahara), the master just cycles through the 5 fast blinks with nothing from the slave. I'll have to take a closer look with a scope next time to see what's going on at the optocoupler. I paralleled a 1.5K ohm resistor with R6 to source enough current on 12VAC. Thoughts? If more help is needed I can start a new thread.

DudeYarvie, 2023-03-30:
Opened a separate  for the post above.

In regards to, what are the correct fuse settings?  The correct fuse settings are below.  I will correct the fuse name settings provided in [Update Shahara_ATmega328p_MCU_FUSE_Settings.txt](https://github.com/DudeYarvie/JARViE_Home_Automation_Modem/commit/b0735e7ec43ef29e897dd35bf4958611dc099d51)

EXTENDED = 0xFD (valid)
HIGH = 0xDE (valid)
LOW = 0xFF (valid)

Fuse Names,
BODLEVEL = 2V7
RSTDISBL = [ ]
DWEN = [ ]
SPIEN = [X]
WDTON = [ ]
EESAVE = [ ]
BOOTSZ = 256W_3F00
BOOTRST = [X]
CKDIV8 = [ ]
CKOUT = [ ]
SUT_CKSEL = EXTXOSC_8MHZ_XX_16KCK_14CK_65MS

DudeYarvie, 2023-03-31:
I deleted your comment above and opened a new issue.

In regards to, what are the correct fuse settings?  The correct settings are below.  I corrected the "Fuse Names" section of [Update Shahara_ATmega328p_MCU_FUSE_Settings.txt](https://github.com/DudeYarvie/JARViE_Home_Automation_Modem/commit/b0735e7ec43ef29e897dd35bf4958611dc099d51)

EXTENDED = 0xFD (valid)
HIGH = 0xDE (valid)
LOW = 0xFF (valid)

Fuse Names,
BODLEVEL = 2V7
RSTDISBL = [ ]
DWEN = [ ]
SPIEN = [X]
WDTON = [ ]
EESAVE = [ ]
BOOTSZ = 256W_3F00
BOOTRST = [X]
CKDIV8 = [ ]
CKOUT = [ ]
SUT_CKSEL = EXTXOSC_8MHZ_XX_16KCK_14CK_65MS

DudeYarvie, 2023-12-24:
@Intechgreater is this still an open issue or did we get the fuse settings sorted out?

Intechgreater, 2024-01-01:
The fuse settings are resolved. Thanks!

Closed 2024-01-18.

Thread 8 (2023-03-30):

Unsuccessful communications with 12VAC powerline generated from a transformer

DudeYarvie, 2023-03-30:
While waiting for a real programmer compatible with Atmel Studio to arrive, I was able to learn how to read/set the fuse registers and upload the binaries you provided via command line using avrdude. Intimidating at first knowing about the risks but relatively easy once acquainted, and satisfying!
Per your suggestion for testing, the master and slave handshake examples each on a Shahara connected together via J1 (no AC power yet), and getting 5V from an UNO, works!
5 fast LED blinks on master -> slave LED on -> 8 slow LED blinks on master -> 5 fast blinks on master -> slave LED off -> 8 slow LED blinks on master, repeat...
However, when the system is connected to 12VAC from a magnetic transformer (converted to 5VDC for circuit power on each Shahara), the master just cycles through the 5 fast blinks with nothing from the slave. I'll have to take a closer look with a scope next time to see what's going on at the optocoupler. I paralleled a 1.5K ohm resistor with R6 to source enough current on 12VAC. Thoughts? If more help is needed we can start a new thread.

_Originally posted by @Intechgreater in https://github.com/DudeYarvie/JARViE_Home_Automation_Modem/issues/6#issuecomment-1487980106_

Intechgreater, 2023-03-31:
Based on your zero cross reference with pulses ~2ms wide, I'm guessing my ~680µs pulses are too short? Which means I need a higher input/lower resistance feeding the optocoupler for the LEDs to turn on sooner & stay on longer?

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

**Optocoupler Input - Cycle**
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

**Optocoupler Input - Pulse**
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

**MCU INT Pin - Cycle**
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

**MCU INT Pin - Pulse**
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

DudeYarvie, 2023-03-31:
@Intechgreater could you supply a block diagram/sketch of the setup with the transformer?

DudeYarvie, 2023-04-01:
From the _Optocoupler Input - Pulse_ plot I understand that the pulse-width/on-time of the zero-cross detection is active for ~8.1ms when a zero crossing event occurs but from the _MCU INT Pin - Pulse (measuring portion Atmega328 considers logic high)_ the INT signal to the MCU is only 680us wide.  I'd place a lower resistance value and drive more current into the optocoupler for starters just to see.  It already seems like you're supplying enough drive current to the optocoupler.  Double-check my math.  With a 1.5k placed in parallel with R6, I calculate that you're driving a peak current and RMS current of,

**1.5k || R6** = 1489.8 Ohms
**Irms** = (15VAC-1.2Vdiode)/1489 = 9 mArms
**Ipeak** = Vpeak/1.5k =[ ([(15VAC*2.8284)/2]) - 1.2Vdiode]*1.5e3 = 13.3 mApeak

Intechgreater, 2023-04-01:
Thanks for the feedback.

Did some more probing and swapping elements out. Looks like the module I'm converting 12VAC to 5VDC with to power the boards is distorting the modem signals too much somehow? The module is a small constant-current LED driver modified by having a 5V regulator connected to the converted/protected power & ground traces on the driver board at the locations shown:

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

In the following screenshots, CH1 = Tx and CH2 = Rx on the Slave board. The master board is running the handshake code with the zero-cross detection lines commented out. For troubleshooting the boards are being powered by an Uno in all instances. Transformer output & J1 on boards all connected together in parallel. Can still provide a block diagram.

**Transformer OFF:**
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

**Transformer OFF zoomed in:**
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

**Transformer ON:**
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

**Transformer ON zoomed in:**
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

**Transformer ON with LED driver/light connected to transformer output (along with boards, all in parallel)**
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

**Same capture zoomed in:**
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

DudeYarvie, 2023-04-02:
Thanks for he system diagram.  I agree, the LED driver is what's causing comm issues.  It appears that it's distorting the PLM comm signal because it's loading it.  I'd attempt to make the LED driver input appear invisible to the PLM comms.  Said another way, make the LED driver input impedance as high as possible at the PLM comm frequency.   Try adding a common-mode choke/AC line filter in series between the CC Triple LED Driver and the transformer connection.  I'm not sure what the power requirements are for the LED driver but I suggest one of the choke/AC line filters from the KEMET 21NVS-M/NHS-M series.  To solve issues like these I've used MPN: SSR21NVS-M12220, which is a 22mH,1.2A DCR=0.35mOhms choke.   The KEMET series offers a good amount of options.  How I went about selecting one was, first I needed to pick a choke with low DCR and one that could handle the current needed.  In this case, the max current required by the LED driver.  Then, I went to the _Frequency Requirements_ section of the 21NVS-M/NHS-M series datasheet and looked at the impedance that choke would provide at the PLM comm frequency (e.x. 125 kHz).  The SSR21NVS-M12220 choke appears as ~20 kOhm @ 125 kHz.  Other chokes present higher impedances at this frequency but may have a lower current rating.  Look at the KEMET datasheet and pick one that can support the max LED driver current.

Intechgreater, 2023-04-03:
I appreciate the explanation and suggestion - ordering a few of those options to test.  It's nice how it's a single component addition. For later modifications to reduce the size of the overall setup, I wonder if there are other approaches to change the driver impedance at comm frequencies, that take up less space (but maybe require more components), and/or a matter of changing driver component values?

DudeYarvie, 2023-12-24:
@Intechgreater I'm sure there's physically smaller chokes that could be used but the one I suggested has been proven to solve issues like this in the past.  If it solves the problem, then let's look into a smaller choke.  Did you ever order and insert the suggested chokes between the CC Triple LED Driver and the 12VAC power line connection to see if this fixed the comm issue while the LED driver is terminated to the power line?

Intechgreater, 2024-01-01:
The chokes fixed the issue! I meant to provide an update back when I tried it but ended up having to pause the entire project for a while since priorities shifted. I'm planning to get back to it for further refinement...

DudeYarvie, 2024-01-18:
Cool. Thanks for the update. Closing this issue.

Closed 2024-01-18.
