DudeYarvie/JARViE_Home_Automation_Modem/Reference Docs/RPI HAT/SCH, 11171957_PLM_RPI_HAT_r1.pdf

A

A

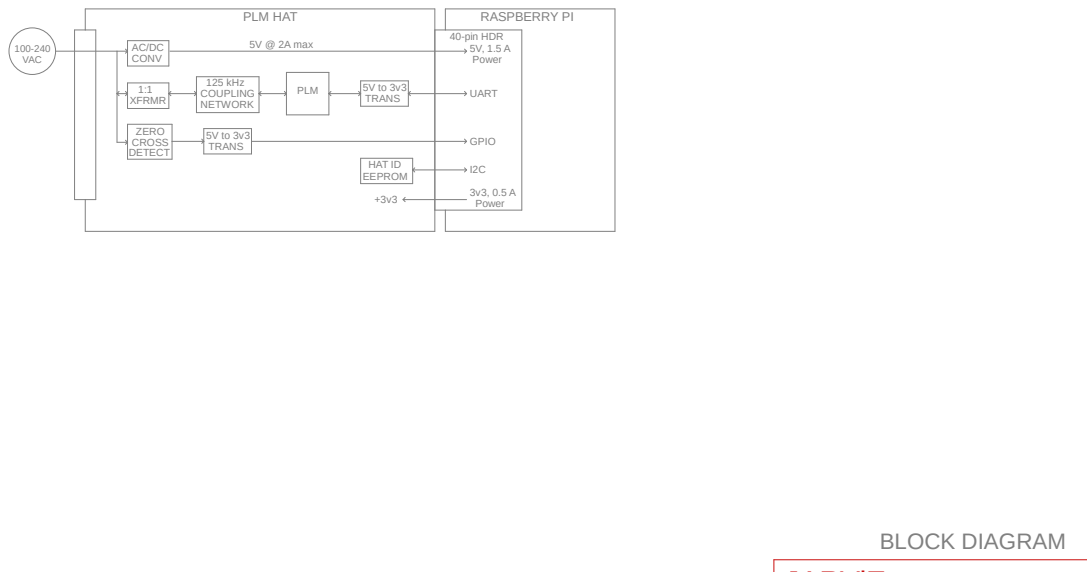
[picture p47: page 1]
BLOCK DIAGRAM; RASPBERRY PI; 40-pin HDR; PLM HAT; PLM; VAC; CONV; 5V @ 2A max; 125 kHz COUPLING NETWORK; 1:1 XFRMR; ZERO CROSS DETECT; UART; GPIO; 5V, 1.5 A Power; HAT ID; EEPROM; 3v3, 0.5 A Power; 5V to 3v3 TRANS; JARViE; PFLUGERVILLE, TX; TITLE:; 11171957_PLM_RPI_HAT

TAKE CHARGE OF YOUR LEARNING

Document Number: 11171957 1.0 | REV:

Date: 7/25/2026 9:44 PM | Sheet: 1/3

# ZERO CROSS DETECTOR

# 2.2M 10K ¹⁰K

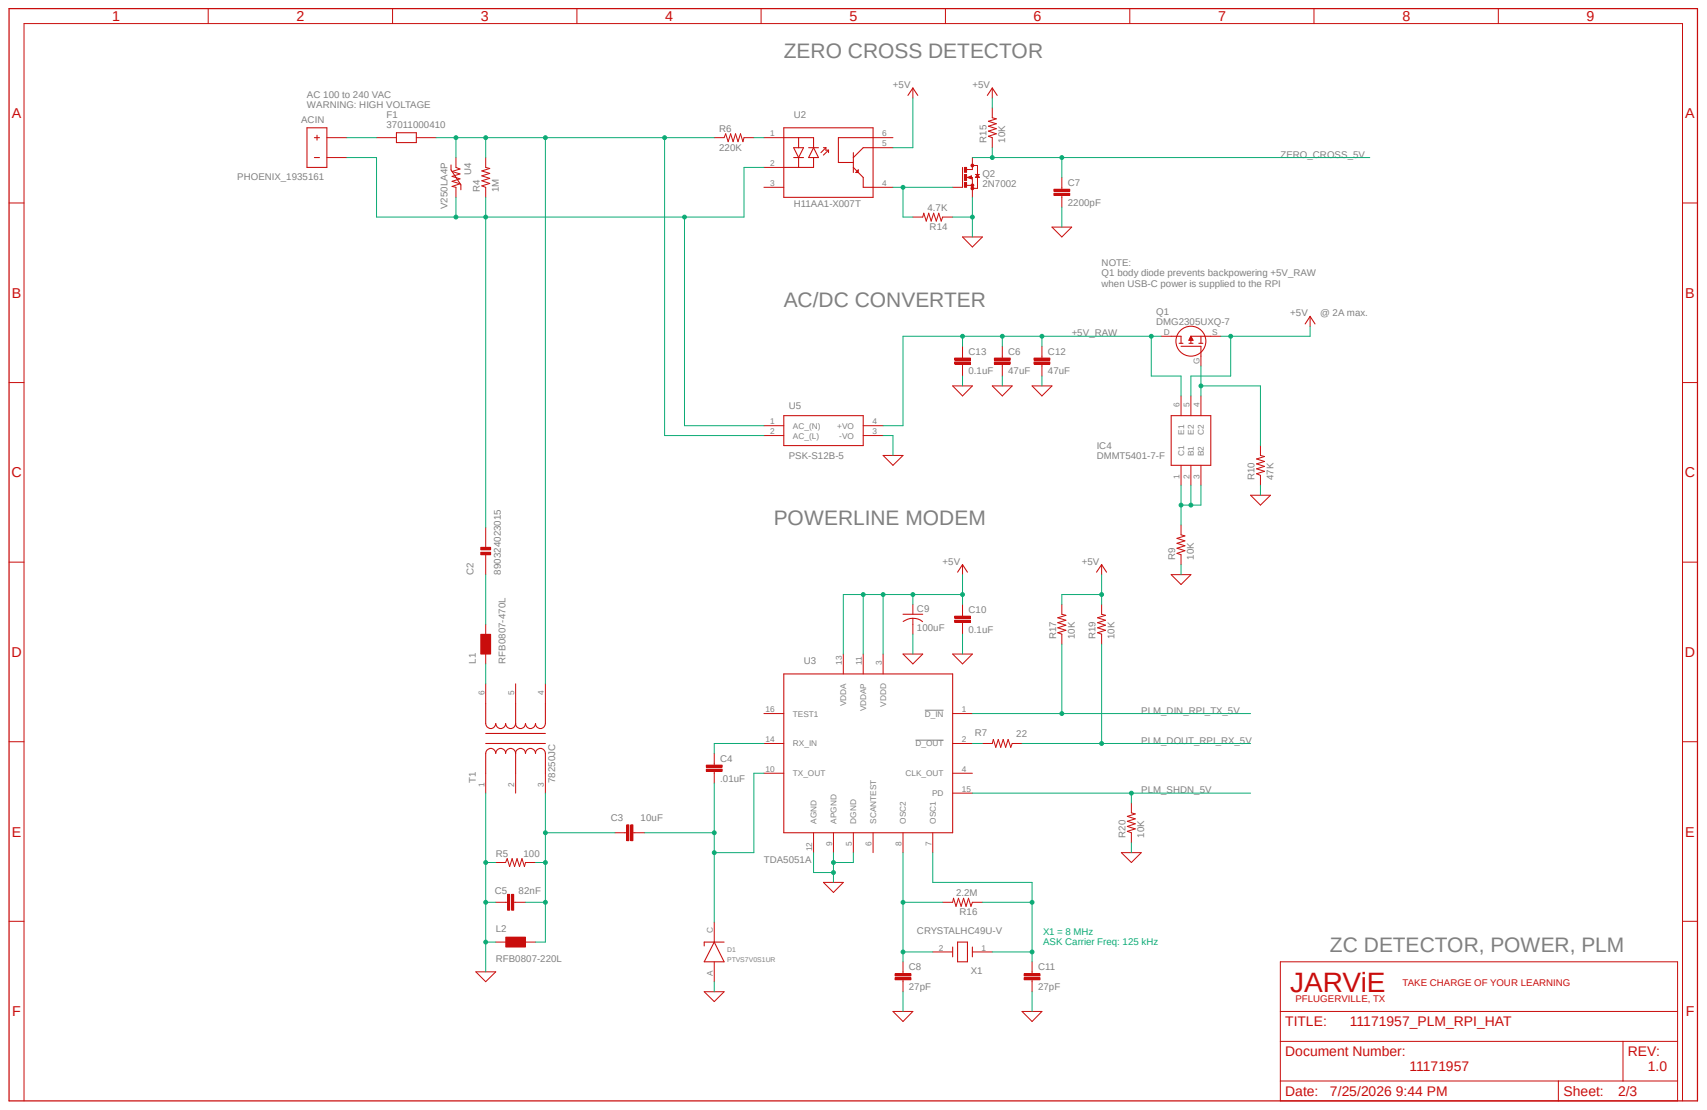
[picture p48: page 2]

when USB-C power is supplied to the RPI 78250JC

7 CLK_OUT 4 PD 15 D_OUT 2 D_IN 1 VDDA 13 VDDAP 11 VDDD

X1 = 8 MHz
ASK Carrier Freq: 125 kHz

ZC DETECTOR, POWER, PLM
JARViE

TAKE CHARGE OF YOUR LEARNING

Document Number: 11171957 1.0 | REV:

# RPI to PLM DIO LEVEL TRANSLATION

# RPI HDR & ID EEPROM

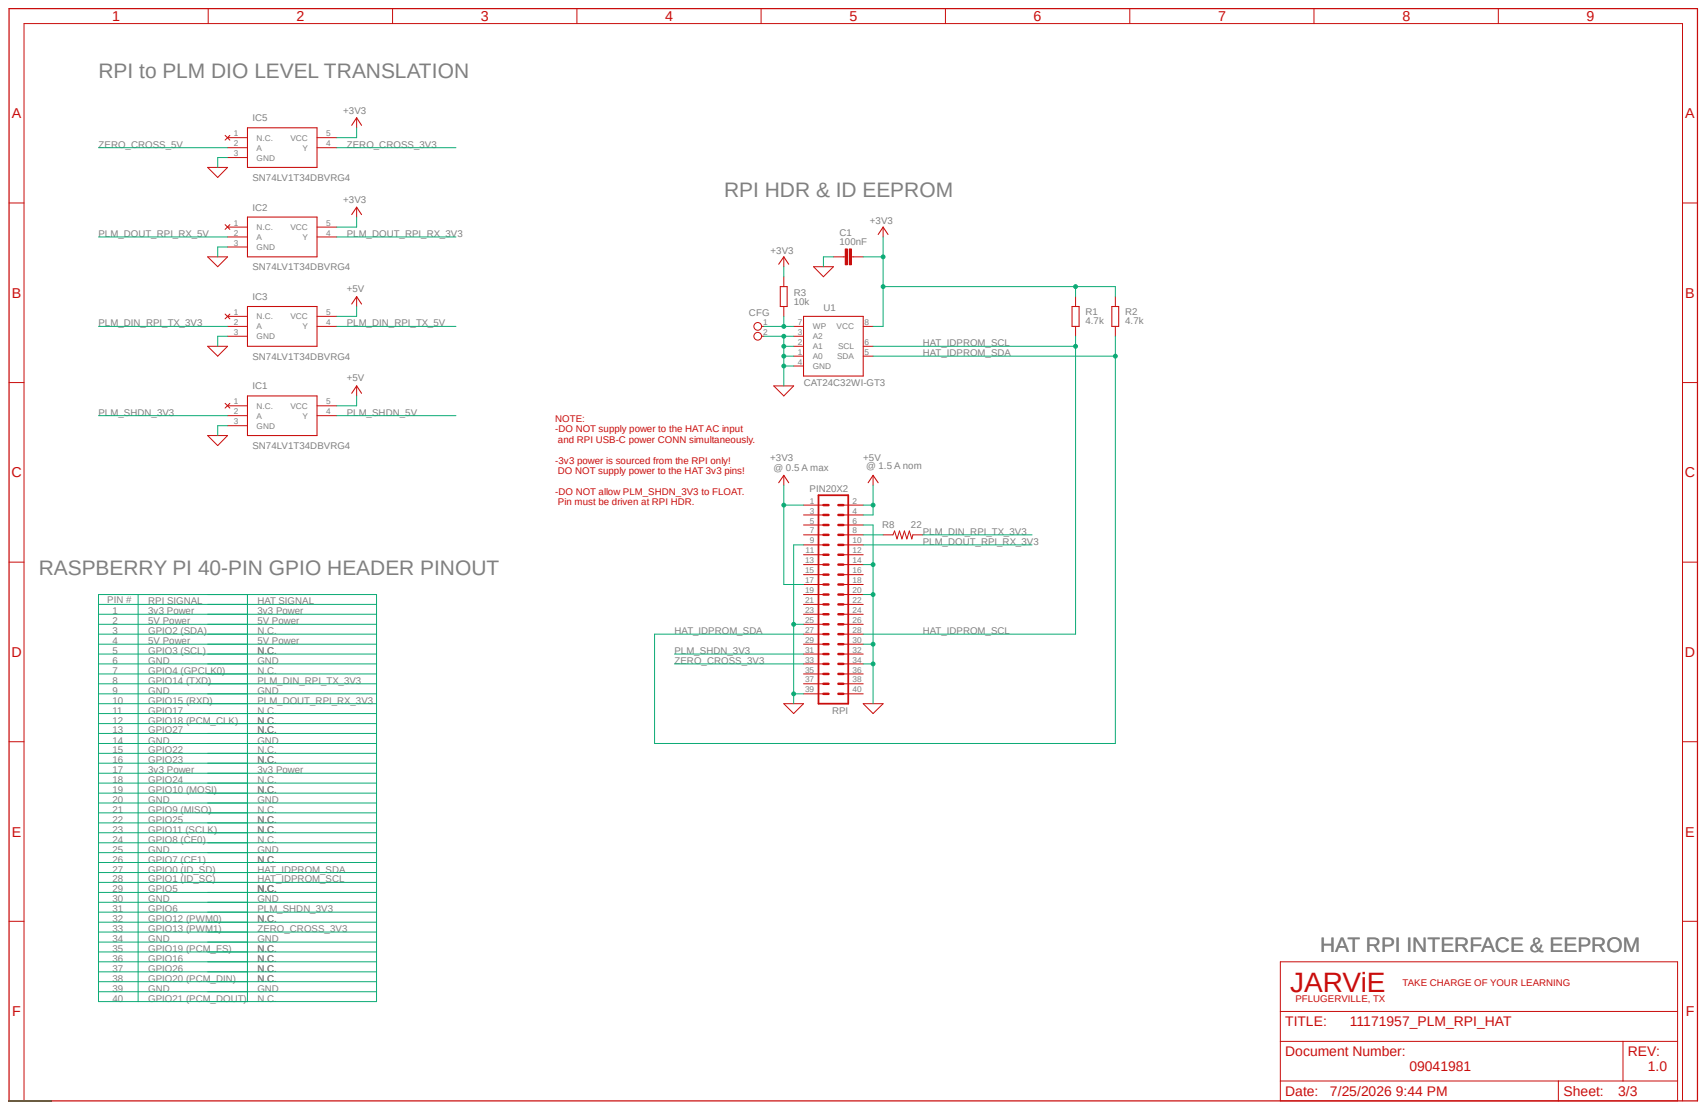
[picture p49: page 3]

NOTE:
-DO NOT supply power to the HAT AC input
and RPI USB-C power CONN simultaneously.
-3v3 power is sourced from the RPI only!
DO NOT supply power to the HAT 3v3 pins!
-DO NOT allow PLM_SHDN_3V3 to FLOAT.
Pin must be driven at RPI HDR.

RASPBERRY PI 40-PIN GPIO HEADER PINOUT

10 | GPIO15 (RXD) | PLM_DOUT_RPI_RX_3V3
11 | GPIO17 | N.C.
12 | GPIO18 (PCM_CLK) | N.C.
13 | GPIO27 | N.C.
14 | GND | GND
16 | GPIO23 | N.C.
17 | 3v3 Power | 3v3 Power
18 | GPIO24 | N.C.
19 | GPIO10 (MOSI) | N.C.
20 | GND | GND
21 | GPIO9 (MISO) | N.C.
22 | GPIO25 | N.C.
23 | GPIO11 (SCLK) | N.C.
24 | GPIO8 (CE0) | N.C.
25 | GND | GND
26 | GPIO7 (CE1) | N.C.
27 | GPIO0 (ID_SD) | HAT_IDPROM_SDA
28 | GPIO1 (ID_SC) | HAT_IDPROM_SCL
29 | GPIO5 | N.C.
30 | GND | GND
31 | GPIO6 | PLM_SHDN_3V3
32 | GPIO12 (PWM0) | N.C.
34 | GND | GND
35 | GPIO19 (PCM_FS) | N.C.
36 | GPIO16 | N.C.
38 | GPIO20 (PCM_DIN) | N.C.
39 | GND | GND
40 | GPIO21 (PCM_DOUT) | N.C.

HAT RPI INTERFACE & EEPROM
JARViE

TAKE CHARGE OF YOUR LEARNING

Document Number: 09041981 1.0 | REV:
