DudeYarvie/JARViE_Home_Automation_Modem/Reference Docs/Breakout Board/SCH_JARViE_Power_Line_Modem_r4.pdf

A

A

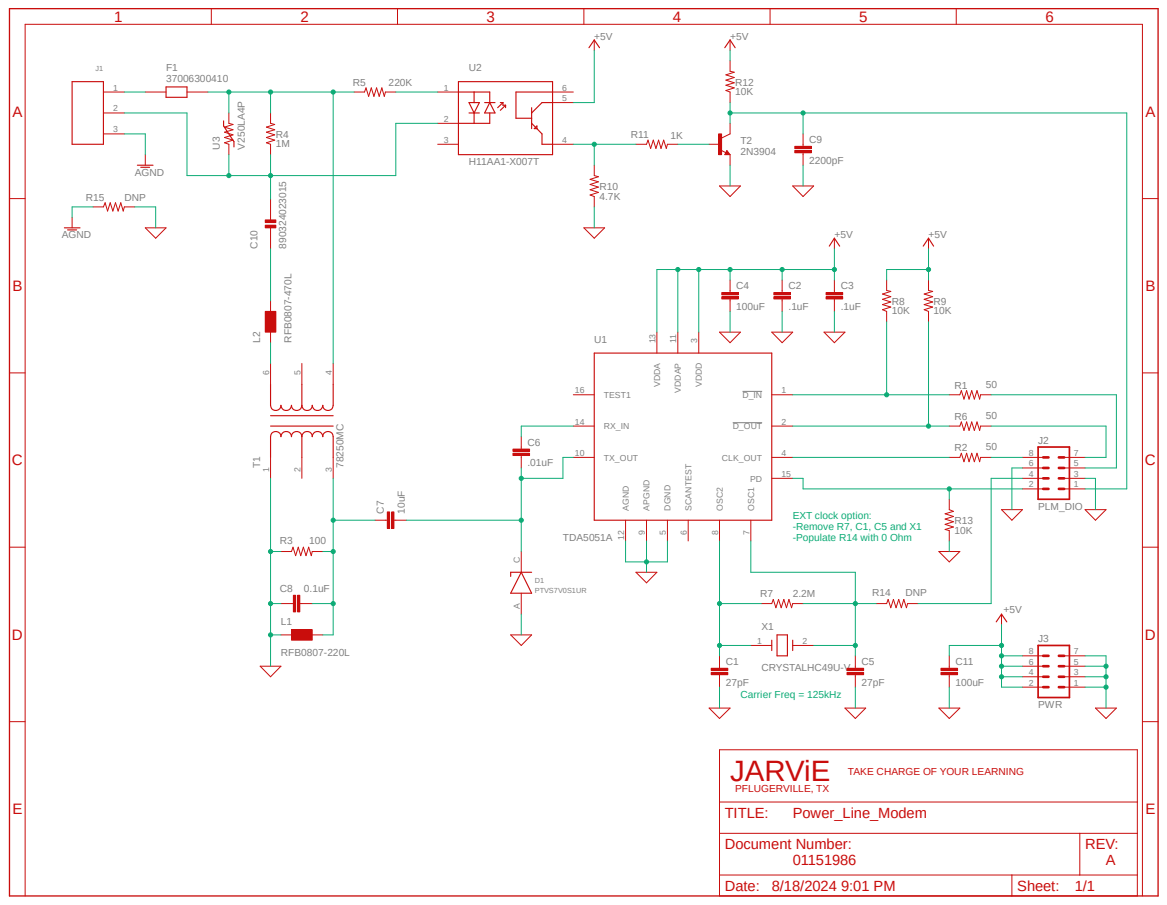
[picture p50: page 1]

7 CLK_OUT 4 PD 15 D_OUT 2 D_IN 1 VDDA 13 VDDAP 11 VDDD

TAKE CHARGE OF YOUR LEARNING

Document Number: 01151986 A | REV:

Date: 8/18/2024 9:01 PM | Sheet: 1/1
