DudeYarvie/JARViE_Home_Automation_Modem/Reference Docs/Arduino Shield/SCH, Power_Line_Modem_Shield_v2.0.pdf

A

A

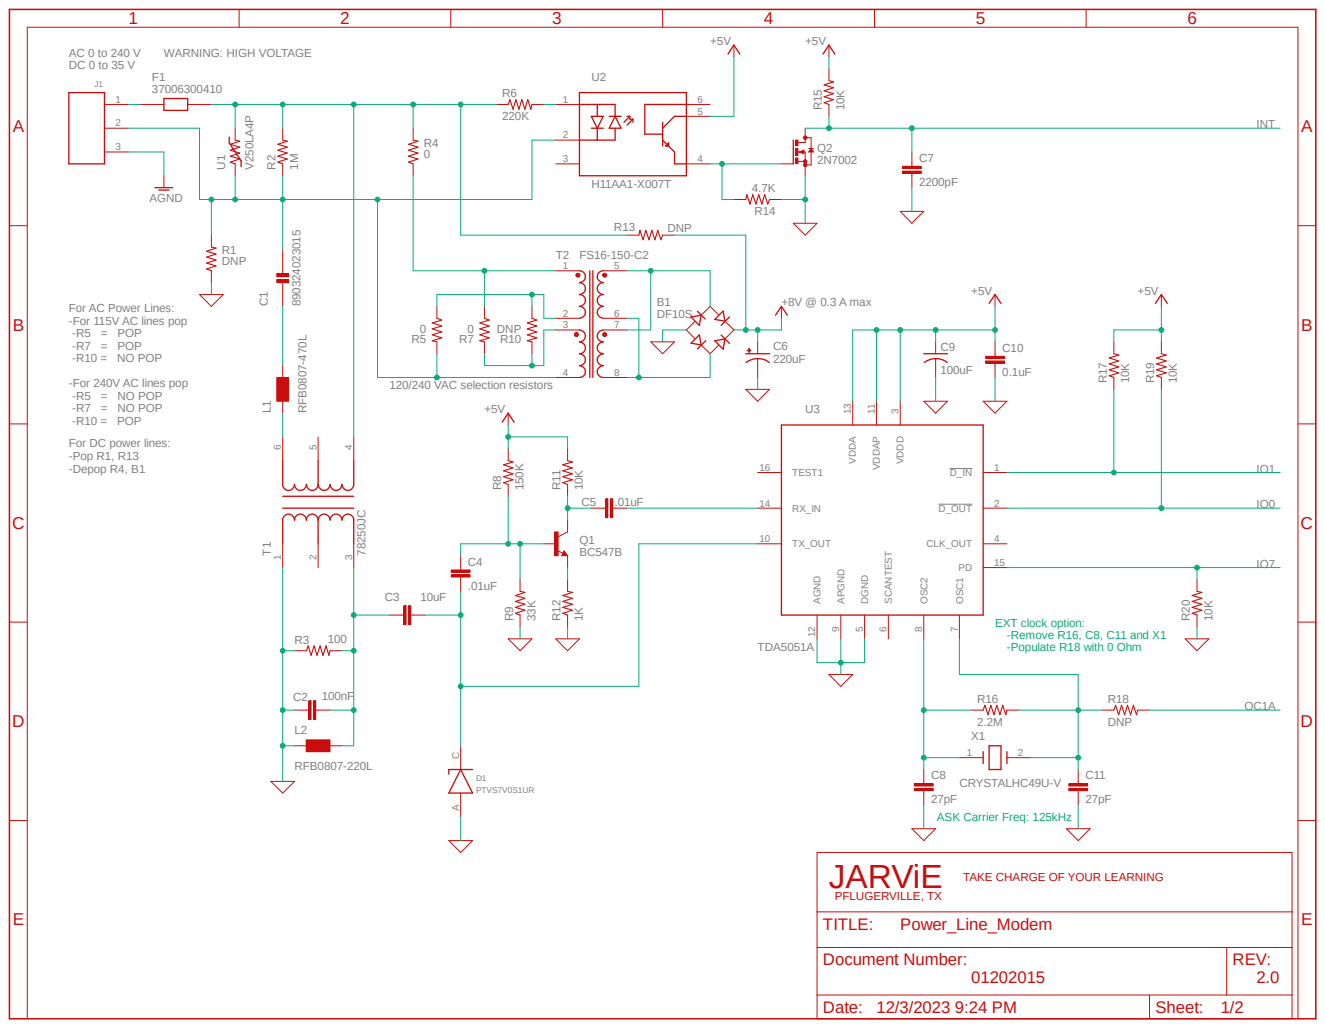
[picture p51: page 1]

@ 0.3 A max For AC Power Lines:
-For 115V AC lines pop
-R5 = POP
-R7 = POP
-R10 = NO POP

-For 240V AC lines pop
-R5 = NO POP
-R7 = NO POP
-R10 = POP

For DC power lines:
-Pop R1, R13
-Depop R4, B1

TAKE CHARGE OF YOUR LEARNING

Document Number: 01202015 | REV: 2.0

Date: 12/3/2023 9:24 PM | Sheet: 1/2

A

A

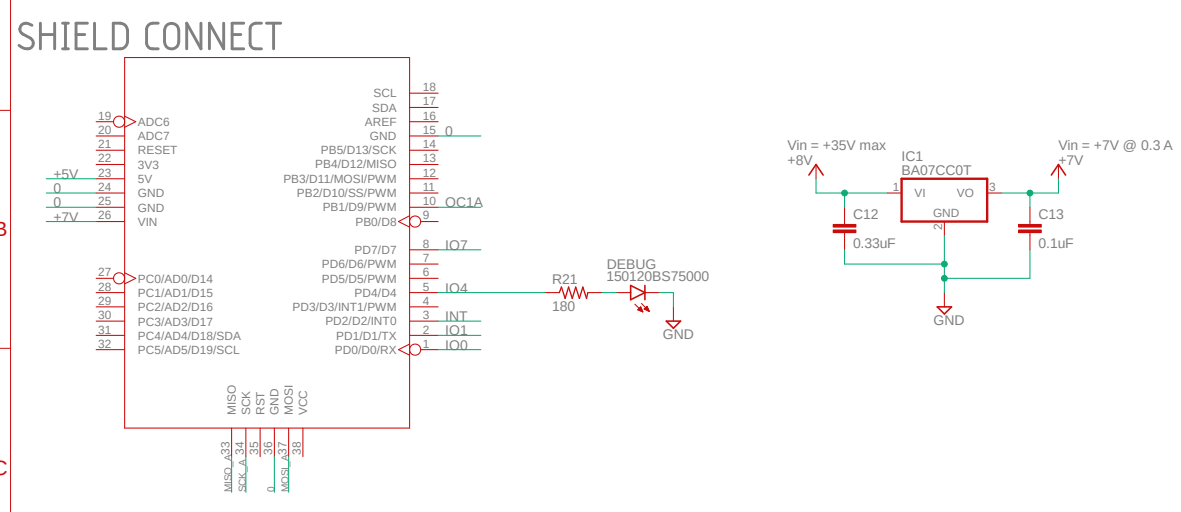
[picture p52: page 2]
Vin = +35V max; Vin = +7V @ 0.3 A; GND; 2 PD2/D2/INT0; 3 PD3/D3/INT1/PWM; 5 PD5/D5/PWM; 6 PD6/D6/PWM; 9 PB1/D9/PWM; 10 PB2/D10/SS/PWM; 11 PB3/D11/MOSI/PWM; 12 PB4/D12/MISO; 13 PB5/D13/SCK; 14 GND; 15 AREF; 16 ADC6 19; ADC7 20; RESET 21; GND 24; GND 25; VIN 26; PC0/AD0/D14 27 PC1/AD1/D15 28 PC2/AD2/D16 29 PC3/AD3/D17 30 PC4/AD4/D18/SDA 31 PC5/AD5/D19/SCL 32; VCC; MOSI; RST; SCK; MISO; SDA; 17 SCL; DEBUG; INT; MISO_A; SCK_A; MOSI_A; JARViE; PFLUGERVILLE, TX; TITLE:; Power_Line_Modem

TAKE CHARGE OF YOUR LEARNING

Document Number: 01202015 | REV: 2.0

Date: 12/3/2023 9:24 PM | Sheet: 2/2
