DudeYarvie/JARViE_Home_Automation_Modem/Reference Docs/Shahara/SCH, 09041981_PLM_Shahara.pdf

A

A

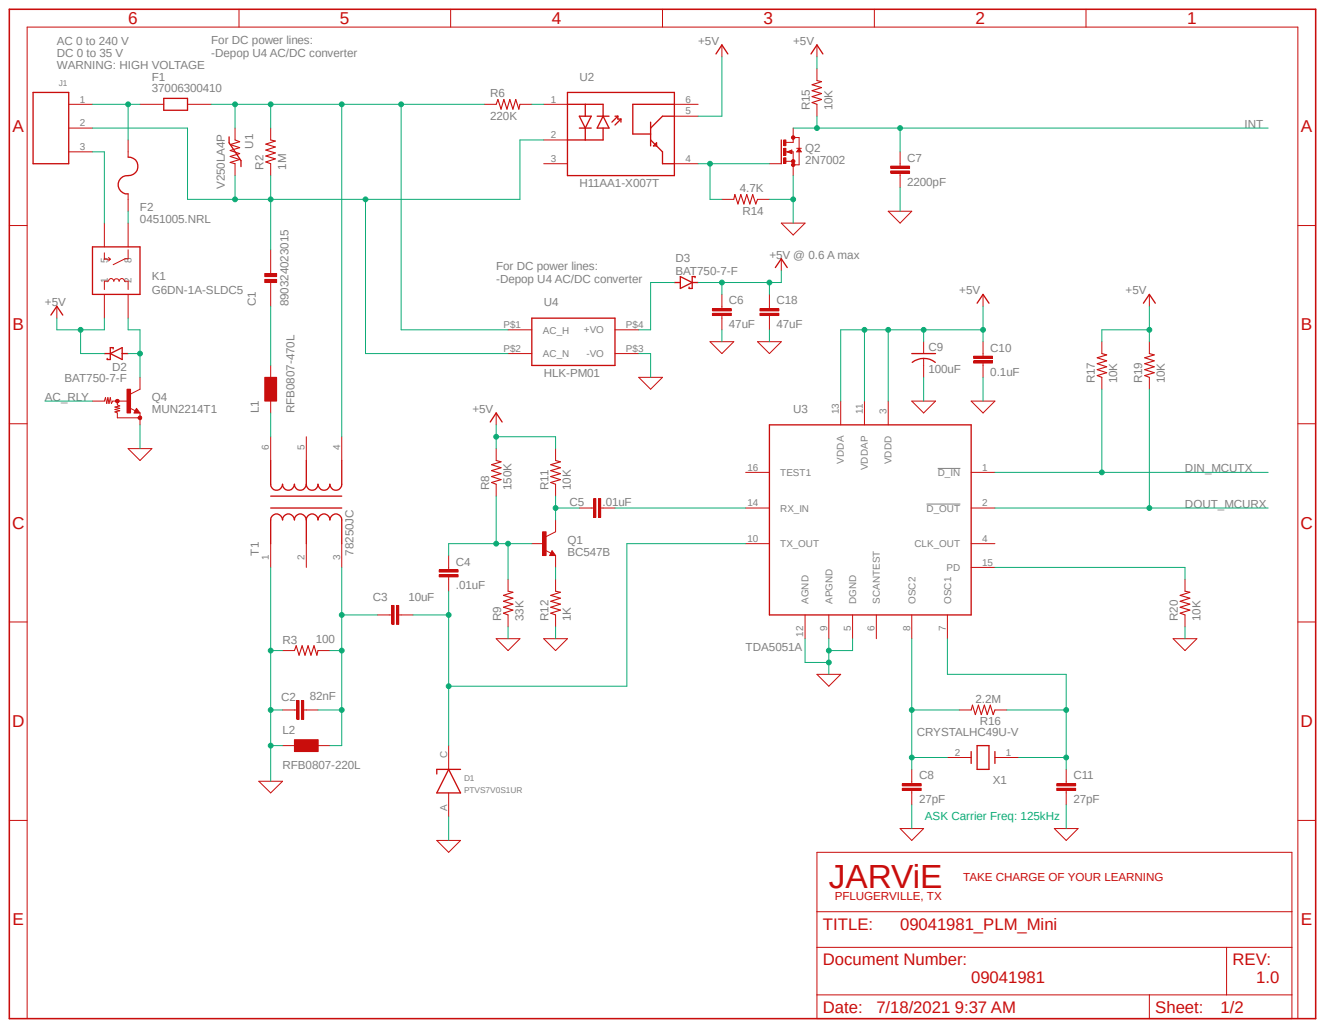
[picture p53: page 1]

AC 0 to 240 V For DC power lines: +5V | +5V

-Depop U4 AC/DC converter

For DC power lines:

TAKE CHARGE OF YOUR LEARNING

Document Number: 09041981 | REV: 1.0

Date: 7/18/2021 9:37 AM | Sheet: 1/2

A

A

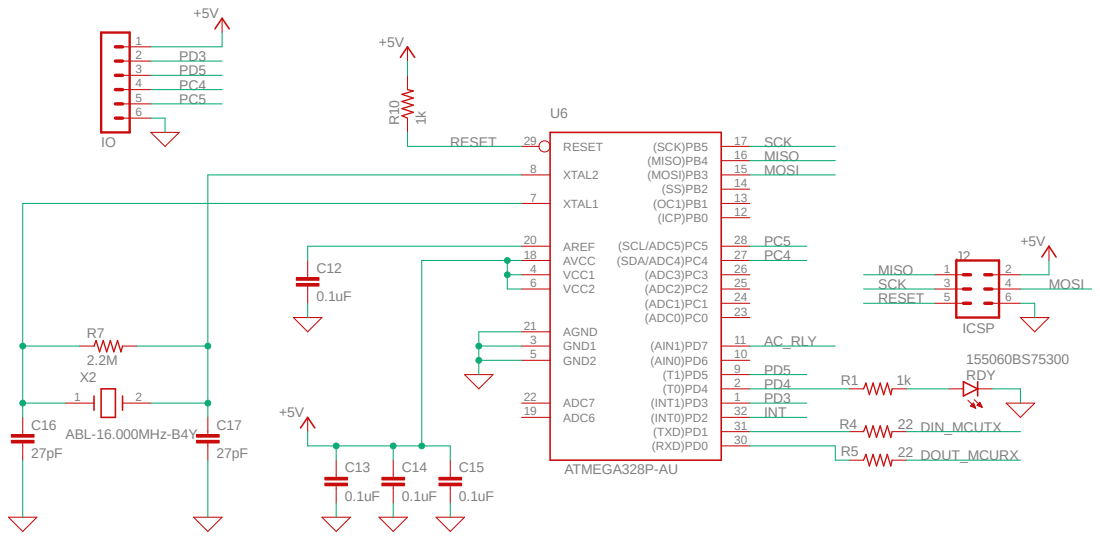
[picture p54: page 2]

TAKE CHARGE OF YOUR LEARNING

Document Number: 09041981 | REV: 1.0

Date: 7/18/2021 9:37 AM | Sheet: 2/2
