DudeYarvie/JARViE_Home_Automation_Modem/Firmware/src/Shield/Examples/PLM_Shield_PingPong_Master_2.0/PLM_Shield_PingPong_Master_2.0.ino

/**
PLM_Shield_PingPong_Master.ino
Author: Jarvis Hill (hilljarvis@gmail.com)
Purpose: Example showing how to send a command to another PLM Shield and wait for a response
Date:03-MAR-2020
References: 
            -TDA5051A datasheet
            -https://github.com/DudeYarvie/JARViE_Home_Automation_Modem
Releases: 
            1.0 - Intial release
            2.0 - Added timeout for PLM communications in PLM.cpp.  One can remove timeout if comms will only be sent from master to slave.  
            If bi-directional comms or handshaking between master and slave is desired, invoking a timeout is encouraged so the PLM bus 
            does not hang when comms are unsucessful.
**/

/*INCLUDES*/
#include "USART.h"
#include "PLM.h"

/*GLOBALS*/
#define MAX_BUF_SIZE 50
char msgBuffer[MAX_BUF_SIZE];                             //Buffer to hold incoming packet

/*PROTOTYPES*/
void PLM_init();
void USART_Init( unsigned int ubrr);
uint16_t fletch_check( uint8_t *data, int count );
char *PLM_read_msg();
void PLM_send_msg( unsigned char data );



void setup() {

  /*Init local variables*/
  uint16_t checksum = 0;
  char msg[11] = "TEMP";
  char buf[6];
  char cmd[50];

  /*Init PLM IO*/
  PLM_init();                                             

  /*Init USART*/
  cli();                                                  //Disable interrupts
  USART_Init(MYUBRR);                                     //Init UART
  sei();                                                  //Enable interrupts
  delay(1000);                                            //Delay

  /*Calculate message checksum*/
  checksum = fletch_check(msg, strlen(msg));              //Calculate Fletcher16 checksum
  //Serial.println(checksum);                             //DEBUG: print checksum for debugging
  sprintf(buf," %u\n",checksum);                          //Construct checksum buffer
  strcat (msg, buf);                                      //Concatenate data message and checksum

  /*Transmit data to slave powerline modem*/
  while (1){
    msgBuffer[MAX_BUF_SIZE]="";                           //Clear msgBuffer

    
    for (int i = 0; i <= 4; i++){                         //Blink DEBUG LED to visually indicate data message will be sent shortly
      PORTD |= (1<<DEBUG_LED);                         
      delay(150);                                         
      PORTD &= ~(1<<DEBUG_LED);
      delay(150);
    }


    /*Send data to slave*/    
    UCSR0B &= ~(1<<RXEN0);                                //Must Disable RX of MCU because PLM comms occur on the same wire 
                                                          //(PLM shield AC couples TX to RX)
    for (int j = 0; j < strlen(msg); j++){                //Send message through USART
      PLM_send_msg(msg[j]);
      delay(10);
    }
    
    delay(500);                                           //Delay after last cmd byte is transmitted                           
    UCSR0B |= (1<<RXEN0);                                 //Enable UART RX
    delay(500);                                           //Required delay to let MCU UART RX circuit to setup

    
    /*Wait for command from slave powerline modem*/
    PLM_read_msg(msgBuffer, MAX_BUF_SIZE);  
    //Serial.println(msgBuffer);                          //DEBUG: print data received from slave

    
    /*Check if the IDN? cmd was received from Host*/
    if(strncmp(msgBuffer,"ACK",strlen("ACK"))==0){       //IF acknowledgement is received 
      for (int k=0;k<8;k++){                             //Blink the debug LED
        PORTD |= (1<<DEBUG_LED);                
        delay(500);                             
        PORTD &= ~(1<<DEBUG_LED);
        delay(500);
      }
    }
    //delay(8000);                                        //Extremely long delay before next round                              
      
  }
}


void loop() {
  //

}
