DudeYarvie/JARViE_Home_Automation_Modem/(commit log)

2019-06-18 Adding schematic
2019-07-05 Add files via upload
    Adding PLM BOM
2019-07-20 Delete SCH_JARViE_Power_Line_Modem.pdf
    Schematic is obsolete
2019-07-30 Create PLM_CCA_Annotated.jpg
    Updated board annotation
2020-01-18 Create SCH, Power_Line_Modem_Shield_v2.0.pdf
2020-01-27 Adding PLM Switch Node Example
2020-11-23 Create BOM, 09041981_PLM_Shahara.pdf
    Adding Shahara BOM
2021-04-27 Adding handshaking example for demo board
2021-07-03 Created "Examples" folder for the Demo Board src
2021-07-22 Delete Power_Line_Modem_Master_1.1.ino
    Src code is outdated
2021-07-22 Delete Power_Line_Modem_Slave_1.1.ino
    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
2021-08-06 Create Shahara_ATmega328p_MCU_FUSE_Settings.txt
    Adding Shahara ATmega328p MCU fuse settings
2021-08-06 Restructured code repo
    Change file structure from 'src' -> boards to 'Firmware' -> 'Binaries', 'src' -> boards
2021-08-06 Added ATmega328p binaries
    Flash these binaries into the ATmega328p MCU using and Atmel flash utility. Use fuse settings document to properly set MCU fuses as well.
2021-08-13 Updated PLM Demo Board BOM
2022-06-19 Updating C8 on Demo Board BOM
2022-08-16 Update SCH, Power_Line_Modem_Shield_v2.0.pdf
2023-09-16 Adding typical PLM on-chip clock circuit diagram
2023-10-22 Adding Ref Docs folder for RPI HAT
    Added SCH and BOM rev1 releases
2023-10-22 Updating SCH and BOM r1 files
2024-08-19 SCH update
    Updated C8 cap value to 0.1uF to match BOM
2024-11-30 Adding electrical specs
    Adding frequency response for PLC coupling circuit
